gabbla/grippyboi/README.md

# GrippyBoi

Open source and open hardware Haldex gen 1 controller.
