gabbla/grippyboi/JLC04161H-7628_stackup.png

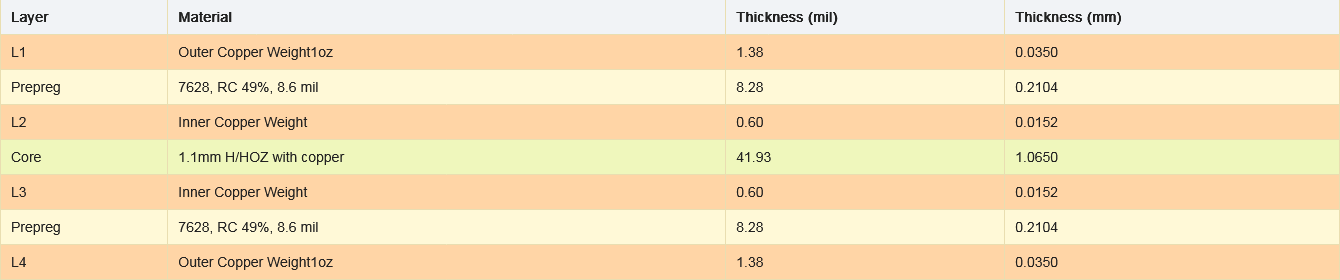
JLC04161H-7628_stackup.png
