gabbla/grippyboi/CHANGELOG.md

# Changelog

## Unreleased

- Fix: Handbrake and Brake light input/output

## [1.0.0] - May 7, 2025

Initial release.
