gabbla/grippyboi/(threads)

Thread 2 (2025-05-22):

F1 is too close to the ECU connector

gabbla, 2025-05-22:

Thread 5 (2025-05-25):

Wrong footprint for L5

gabbla, 2025-05-25:
The footprint for the common mode filter on the usb is wrong.

From the datasheet:
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
