gabbla/grippyboi/grippyboi.kicad_pcb

## KiCad design grippyboi.kicad_pcb (2025-05-07)

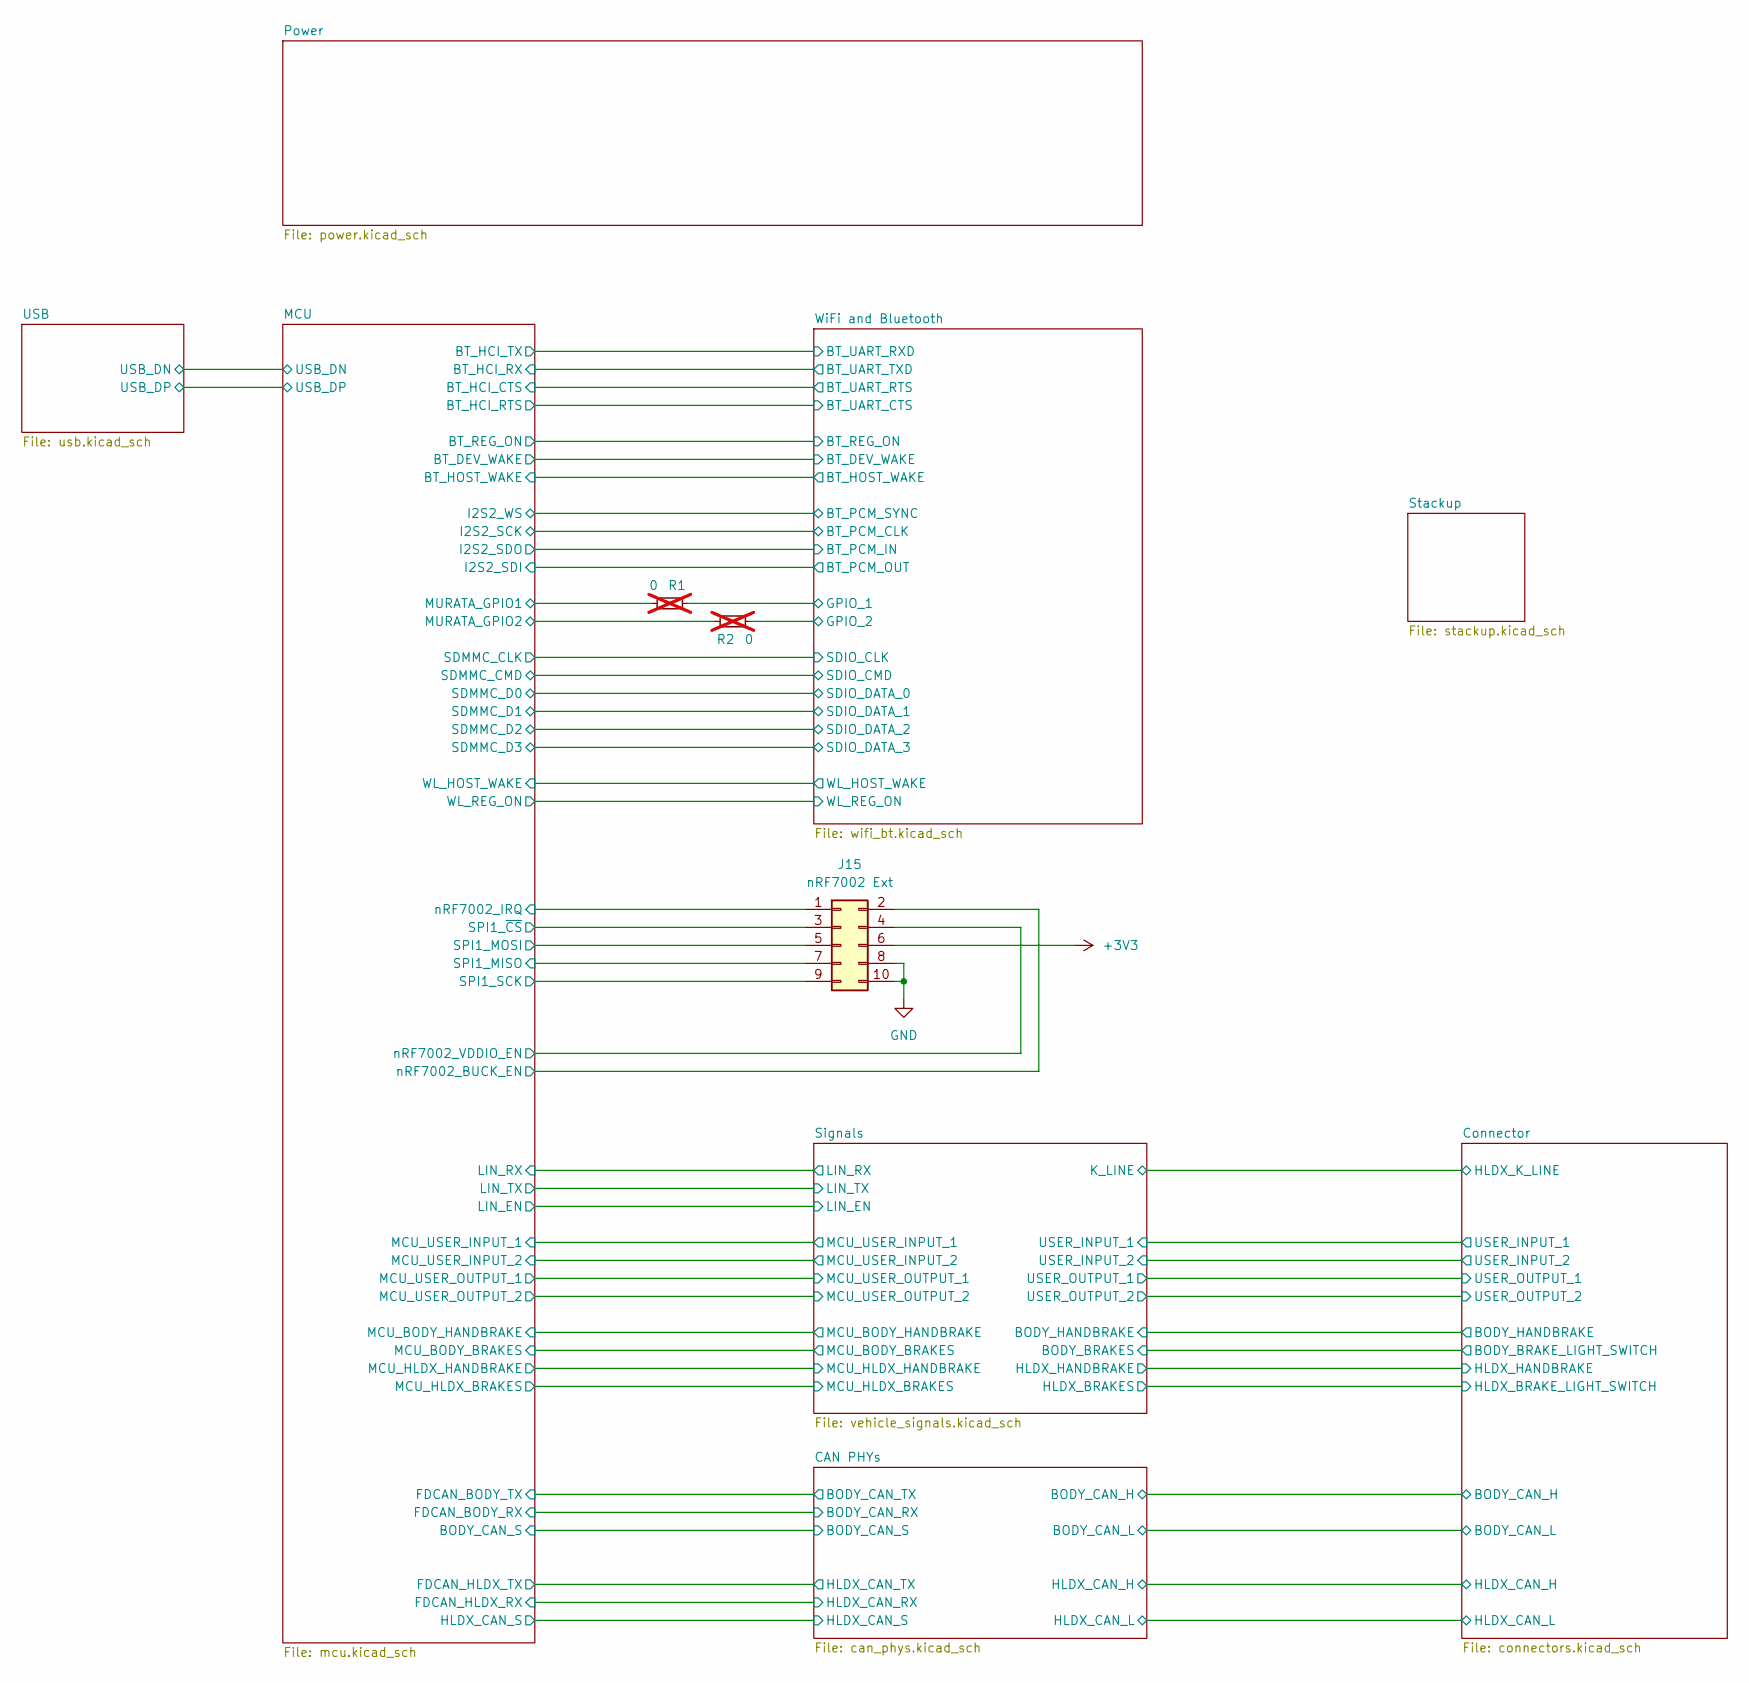
[picture p2: schematic grippyboi.kicad_sch]

Parts:
J15: nRF7002 Ext; PinHeader_2x05_P1.27mm_Vertical
R1, R2: 0; R_0603_1608Metric_Pad0.98x0.95mm_HandSolder; not fitted

Connections:
+3V3: J15.6; also elsewhere on the board
/MCU/MURATA_GPIO1: R1.2; also elsewhere on the board
/MCU/MURATA_GPIO2: R2.1; also elsewhere on the board
/MCU/SPI1_MISO: J15.7; also elsewhere on the board
/MCU/SPI1_MOSI: J15.5; also elsewhere on the board
/MCU/SPI1_SCK: J15.9; also elsewhere on the board
/MCU/SPI1_~CS: J15.3; also elsewhere on the board
/MCU/nRF7002_BUCK_EN: J15.2; also elsewhere on the board
/MCU/nRF7002_IRQ: J15.1; also elsewhere on the board
/MCU/nRF7002_VDDIO_EN: J15.4; also elsewhere on the board
/WiFi and Bluetooth/GPIO_1: R1.1; also elsewhere on the board
/WiFi and Bluetooth/GPIO_2: R2.2; also elsewhere on the board
GND: J15.8, J15.10; also elsewhere on the board

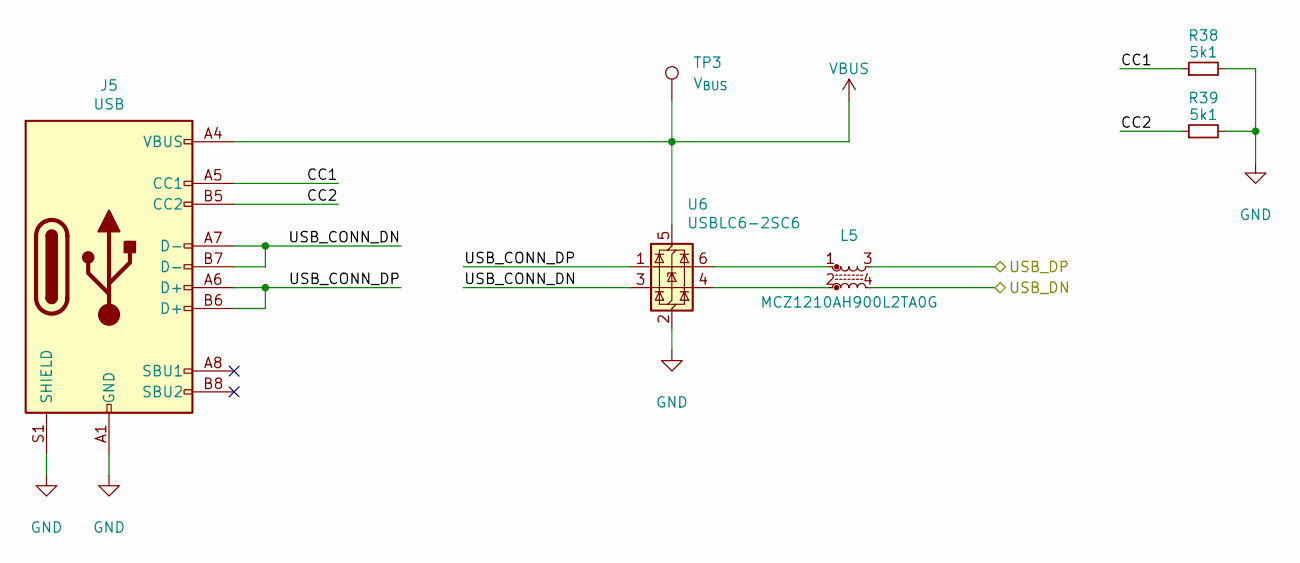
[picture p3: schematic usb.kicad_sch, USB-C]

Parts:
J5: USB; USB_C_Receptacle_G-Switch_GT-USB-7010ASV
L5: MCZ1210AH900L2TA0G; MCZ1210AH201L2TA0G
R38, R39: 5k1; R_0603_1608Metric_Pad0.98x0.95mm_HandSolder
TP3: V_{BUS}; TestPoint_Pad_D1.0mm
U6: USBLC6-2SC6; SOT-23-6

Connections:
/MCU/USB_DN: L5.4; also elsewhere on the board
/MCU/USB_DP: L5.3; also elsewhere on the board
/USB/CC1: J5.A5 (CC1), R38.1
/USB/CC2: J5.B5 (CC2), R39.1
/USB/USB_CONN_DN: J5.A7 (D-), J5.B7 (D-), U6.3 (I/O2)
/USB/USB_CONN_DP: J5.A6 (D+), J5.B6 (D+), U6.1 (I/O1)
GND: J5.A1 (GND), J5.A12 (GND), J5.B1 (GND), J5.B12 (GND), J5.S1 (SHIELD), R38.2, R39.2, U6.2 (GND); also elsewhere on the board
unnamed: L5.1, U6.6 (I/O1)
unnamed: L5.2, U6.4 (I/O2)
VBUS: J5.A4 (VBUS), J5.A9 (VBUS), J5.B4 (VBUS), J5.B9 (VBUS), TP3.1, U6.5 (VBUS)

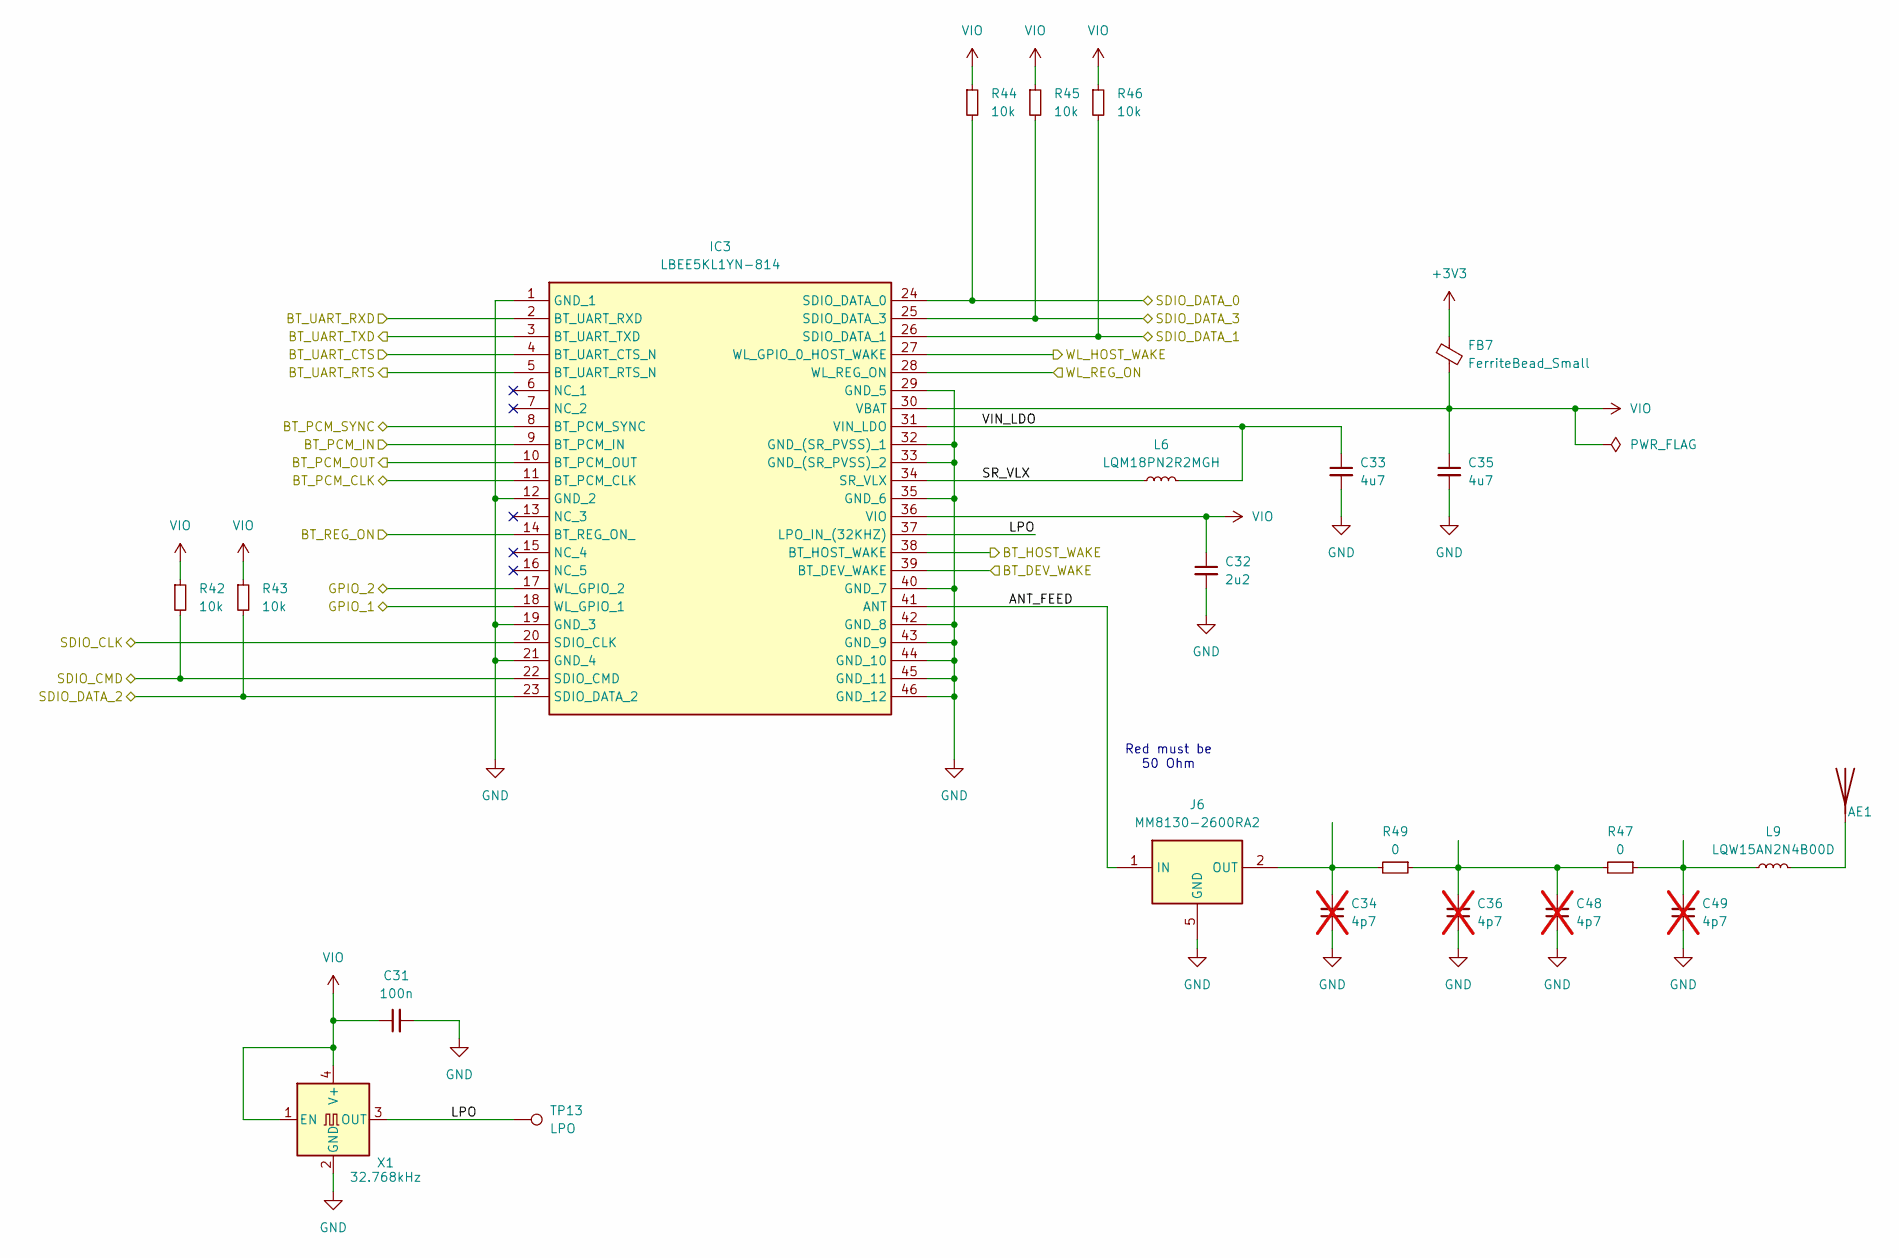
[picture p4: schematic wifi_bt.kicad_sch, WiFi and Bluetooth - Murata 1YN]

Parts:
AE1: type1YN-antenna-p2ml4452-1; 1YN_ANTENNA
C31: 100n; C_0603_1608Metric_Pad1.08x0.95mm_HandSolder
C32: 2u2; C_0603_1608Metric_Pad1.08x0.95mm_HandSolder
C33, C35: 4u7; C_0603_1608Metric_Pad1.08x0.95mm_HandSolder
C34, C36, C48, C49: 4p7; C_0402_1005Metric_Pad0.74x0.62mm_HandSolder; not fitted
FB7: FerriteBead_Small; L_0805_2012Metric_Pad1.05x1.20mm_HandSolder
IC3: LBEE5KL1YN-814; LBEE5KL1YN814; Manufacturer_Part_Number LBEE5KL1YN-814; Mouser Part Number 81-LBEE5KL1YN-814
J6: MM8130-2600RA2; MM81302600RA2; Mouser Part Number 81-MM8130-2600RA2
L6: LQM18PN2R2MGH; L_0603_1608Metric_Pad1.05x0.95mm_HandSolder
L9: LQW15AN2N4B00D; L_0402_1005Metric
R42, R43, R44, R45, R46: 10k; R_0402_1005Metric_Pad0.72x0.64mm_HandSolder
R47, R49: 0; R_0402_1005Metric_Pad0.72x0.64mm_HandSolder
TP13: LPO; TestPoint_Pad_D1.0mm
X1: 32.768kHz; Oscillator_SMD_EuroQuartz_XO32-4Pin_3.2x2.5mm

Connections:
+3V3: FB7.1; also elsewhere on the board
/MCU/BT_DEV_WAKE: IC3.39 (BT_DEV_WAKE); also elsewhere on the board
/MCU/BT_HCI_CTS: IC3.5 (BT_UART_RTS_N); also elsewhere on the board
/MCU/BT_HCI_RTS: IC3.4 (BT_UART_CTS_N); also elsewhere on the board
/MCU/BT_HCI_RX: IC3.3 (BT_UART_TXD); also elsewhere on the board
/MCU/BT_HCI_TX: IC3.2 (BT_UART_RXD); also elsewhere on the board
/MCU/BT_HOST_WAKE: IC3.38 (BT_HOST_WAKE); also elsewhere on the board
/MCU/BT_REG_ON: IC3.14 (BT_REG_ON_); also elsewhere on the board
/MCU/I2S2_SCK: IC3.11 (BT_PCM_CLK); also elsewhere on the board
/MCU/I2S2_SDI: IC3.10 (BT_PCM_OUT); also elsewhere on the board
/MCU/I2S2_SDO: IC3.9 (BT_PCM_IN); also elsewhere on the board
/MCU/I2S2_WS: IC3.8 (BT_PCM_SYNC); also elsewhere on the board
/MCU/SDMMC_CLK: IC3.20 (SDIO_CLK); also elsewhere on the board
/MCU/SDMMC_CMD: IC3.22 (SDIO_CMD), R42.2; also elsewhere on the board
/MCU/SDMMC_D0: IC3.24 (SDIO_DATA_0), R44.2; also elsewhere on the board
/MCU/SDMMC_D1: IC3.26 (SDIO_DATA_1), R46.2; also elsewhere on the board
/MCU/SDMMC_D2: IC3.23 (SDIO_DATA_2), R43.2; also elsewhere on the board
/MCU/SDMMC_D3: IC3.25 (SDIO_DATA_3), R45.2; also elsewhere on the board
/MCU/WL_HOST_WAKE: IC3.27 (WL_GPIO_0_HOST_WAKE); also elsewhere on the board
/MCU/WL_REG_ON: IC3.28 (WL_REG_ON); also elsewhere on the board
/WiFi and Bluetooth/ANT_FEED: IC3.41 (ANT), J6.1 (IN)
/WiFi and Bluetooth/GPIO_1: IC3.18 (WL_GPIO_1); also elsewhere on the board
/WiFi and Bluetooth/GPIO_2: IC3.17 (WL_GPIO_2); also elsewhere on the board
/WiFi and Bluetooth/LPO: IC3.37 (LPO_IN_(32KHZ)), TP13.1, X1.3 (OUT)
/WiFi and Bluetooth/SR_VLX: IC3.34 (SR_VLX), L6.1
/WiFi and Bluetooth/VIN_LDO: C33.1, IC3.31 (VIN_LDO), L6.2
GND: C31.2, C32.2, C33.2, C34.1, C35.2, C36.1, C48.1, C49.1, IC3.1 (GND_1), IC3.12 (GND_2), IC3.19 (GND_3), IC3.21 (GND_4), IC3.29 (GND_5), IC3.32 (GND_(SR_PVSS)_1), IC3.33 (GND_(SR_PVSS)_2), IC3.35 (GND_6), IC3.40 (GND_7), IC3.42 (GND_8), IC3.43 (GND_9), IC3.44 (GND_10), IC3.45 (GND_11), IC3.46 (GND_12), J6.3 (GND), J6.4 (GND), J6.5 (GND), J6.6 (GND), X1.2 (GND); also elsewhere on the board
unnamed: AE1.1 (A), L9.2
unnamed: C36.2, C48.2, R47.2, R49.1
unnamed: C49.2, L9.1, R47.1
unnamed: C34.2, J6.2 (OUT), R49.2
VIO: C31.1, C32.1, C35.1, FB7.2, IC3.30 (VBAT), IC3.36 (VIO), R42.1, R43.1, R44.1, R45.1, R46.1, X1.1 (EN), X1.4 (V+)

Notes on the sheet:
Red must be 50 Ohm

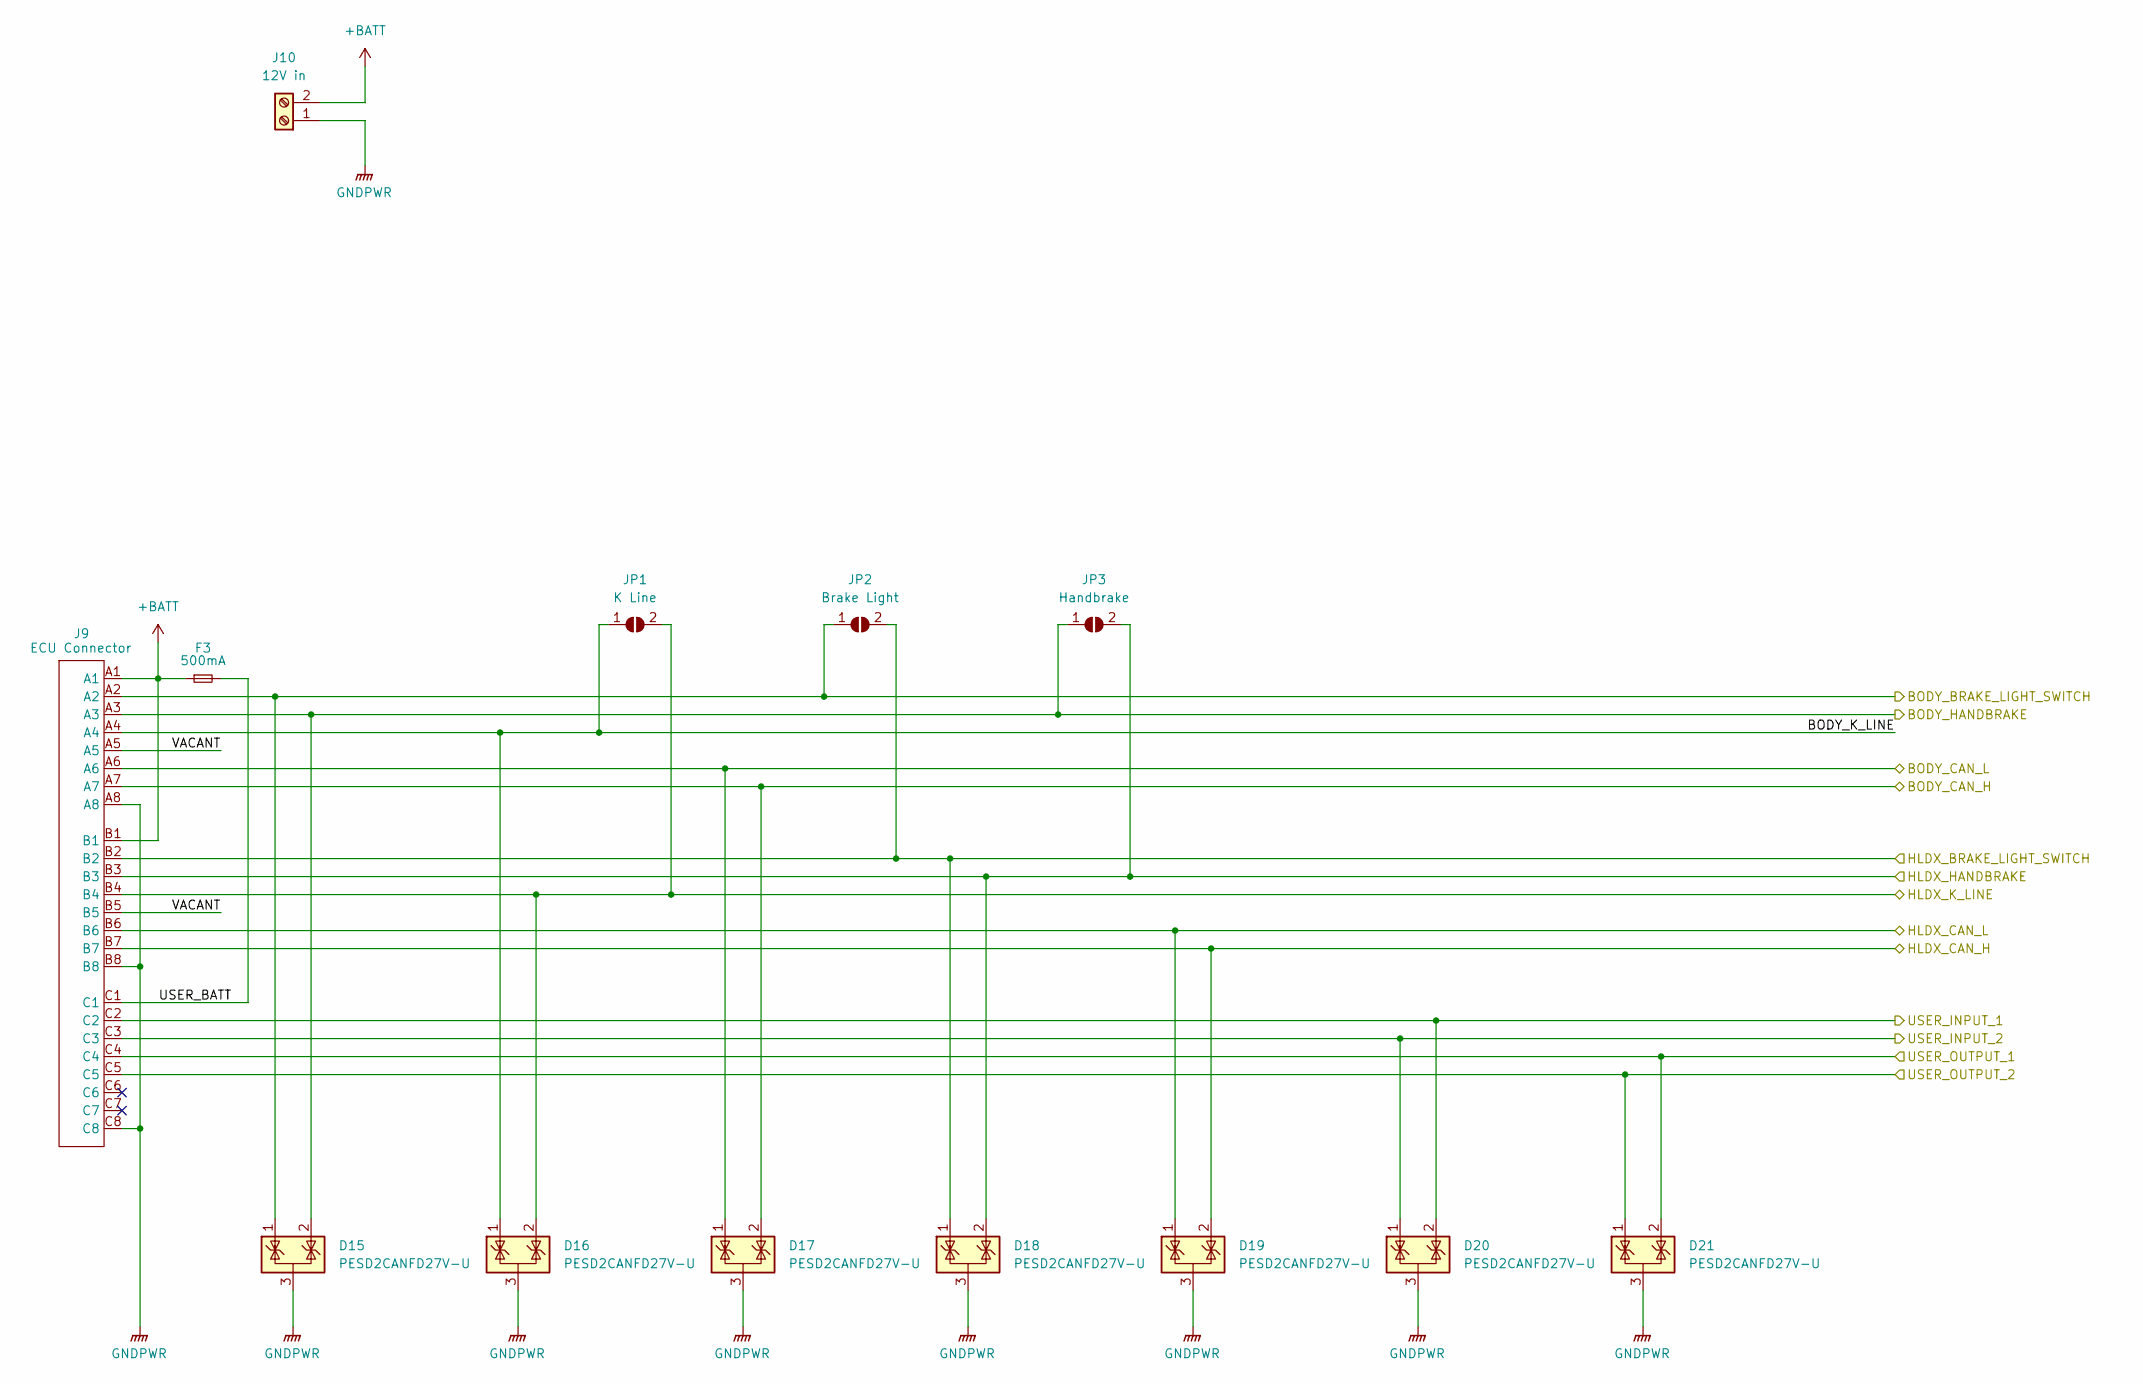
[picture p5: schematic connectors.kicad_sch, Connector]

Parts:
D15, D16, D17, D18, D19, D20, D21: PESD2CANFD27V-U; SOT-23
F3: 500mA; Fuse_1206_3216Metric
J9: ECU Connector; ecu24
J10: 12V in; TerminalBlock_Phoenix_PT-1,5-2-3.5-H_1x02_P3.50mm_Horizontal
JP1: K Line; SolderJumper-2_P1.3mm_Open_TrianglePad1.0x1.5mm
JP2: Brake Light; SolderJumper-2_P1.3mm_Open_TrianglePad1.0x1.5mm
JP3: Handbrake; SolderJumper-2_P1.3mm_Open_TrianglePad1.0x1.5mm

Connections:
+BATT: F3.1, J9.A1, J9.B1, J10.2; also elsewhere on the board
/CAN PHYs/BODY_CAN_H: D17.2 (K), J9.A7; also elsewhere on the board
/CAN PHYs/BODY_CAN_L: D17.1 (K), J9.A6; also elsewhere on the board
/CAN PHYs/HLDX_CAN_H: D19.2 (K), J9.B7; also elsewhere on the board
/CAN PHYs/HLDX_CAN_L: D19.1 (K), J9.B6; also elsewhere on the board
/Connector/BODY_BRAKE_LIGHT_SWITCH: D15.1 (K), J9.A2, JP2.1 (A); also elsewhere on the board
/Connector/BODY_HANDBRAKE: D15.2 (K), J9.A3, JP3.1 (A); also elsewhere on the board
/Connector/BODY_K_LINE: D16.1 (K), J9.A4, JP1.1 (A)
/Connector/HLDX_BRAKE_LIGHT_SWITCH: D18.1 (K), J9.B2, JP2.2 (B); also elsewhere on the board
/Connector/HLDX_HANDBRAKE: D18.2 (K), J9.B3, JP3.2 (B); also elsewhere on the board
/Connector/HLDX_K_LINE: D16.2 (K), J9.B4, JP1.2 (B); also elsewhere on the board
/Connector/USER_BATT: F3.2, J9.C1
/Connector/USER_INPUT_1: D20.2 (K), J9.C2; also elsewhere on the board
/Connector/USER_INPUT_2: D20.1 (K), J9.C3; also elsewhere on the board
/Connector/USER_OUTPUT_1: D21.2 (K), J9.C4; also elsewhere on the board
/Connector/USER_OUTPUT_2: D21.1 (K), J9.C5; also elsewhere on the board
/Connector/VACANT: J9.A5, J9.B5
GNDPWR: D15.3 (A), D16.3 (A), D17.3 (A), D18.3 (A), D19.3 (A), D20.3 (A), D21.3 (A), J9.A8, J9.B8, J9.C8, J10.1; also elsewhere on the board

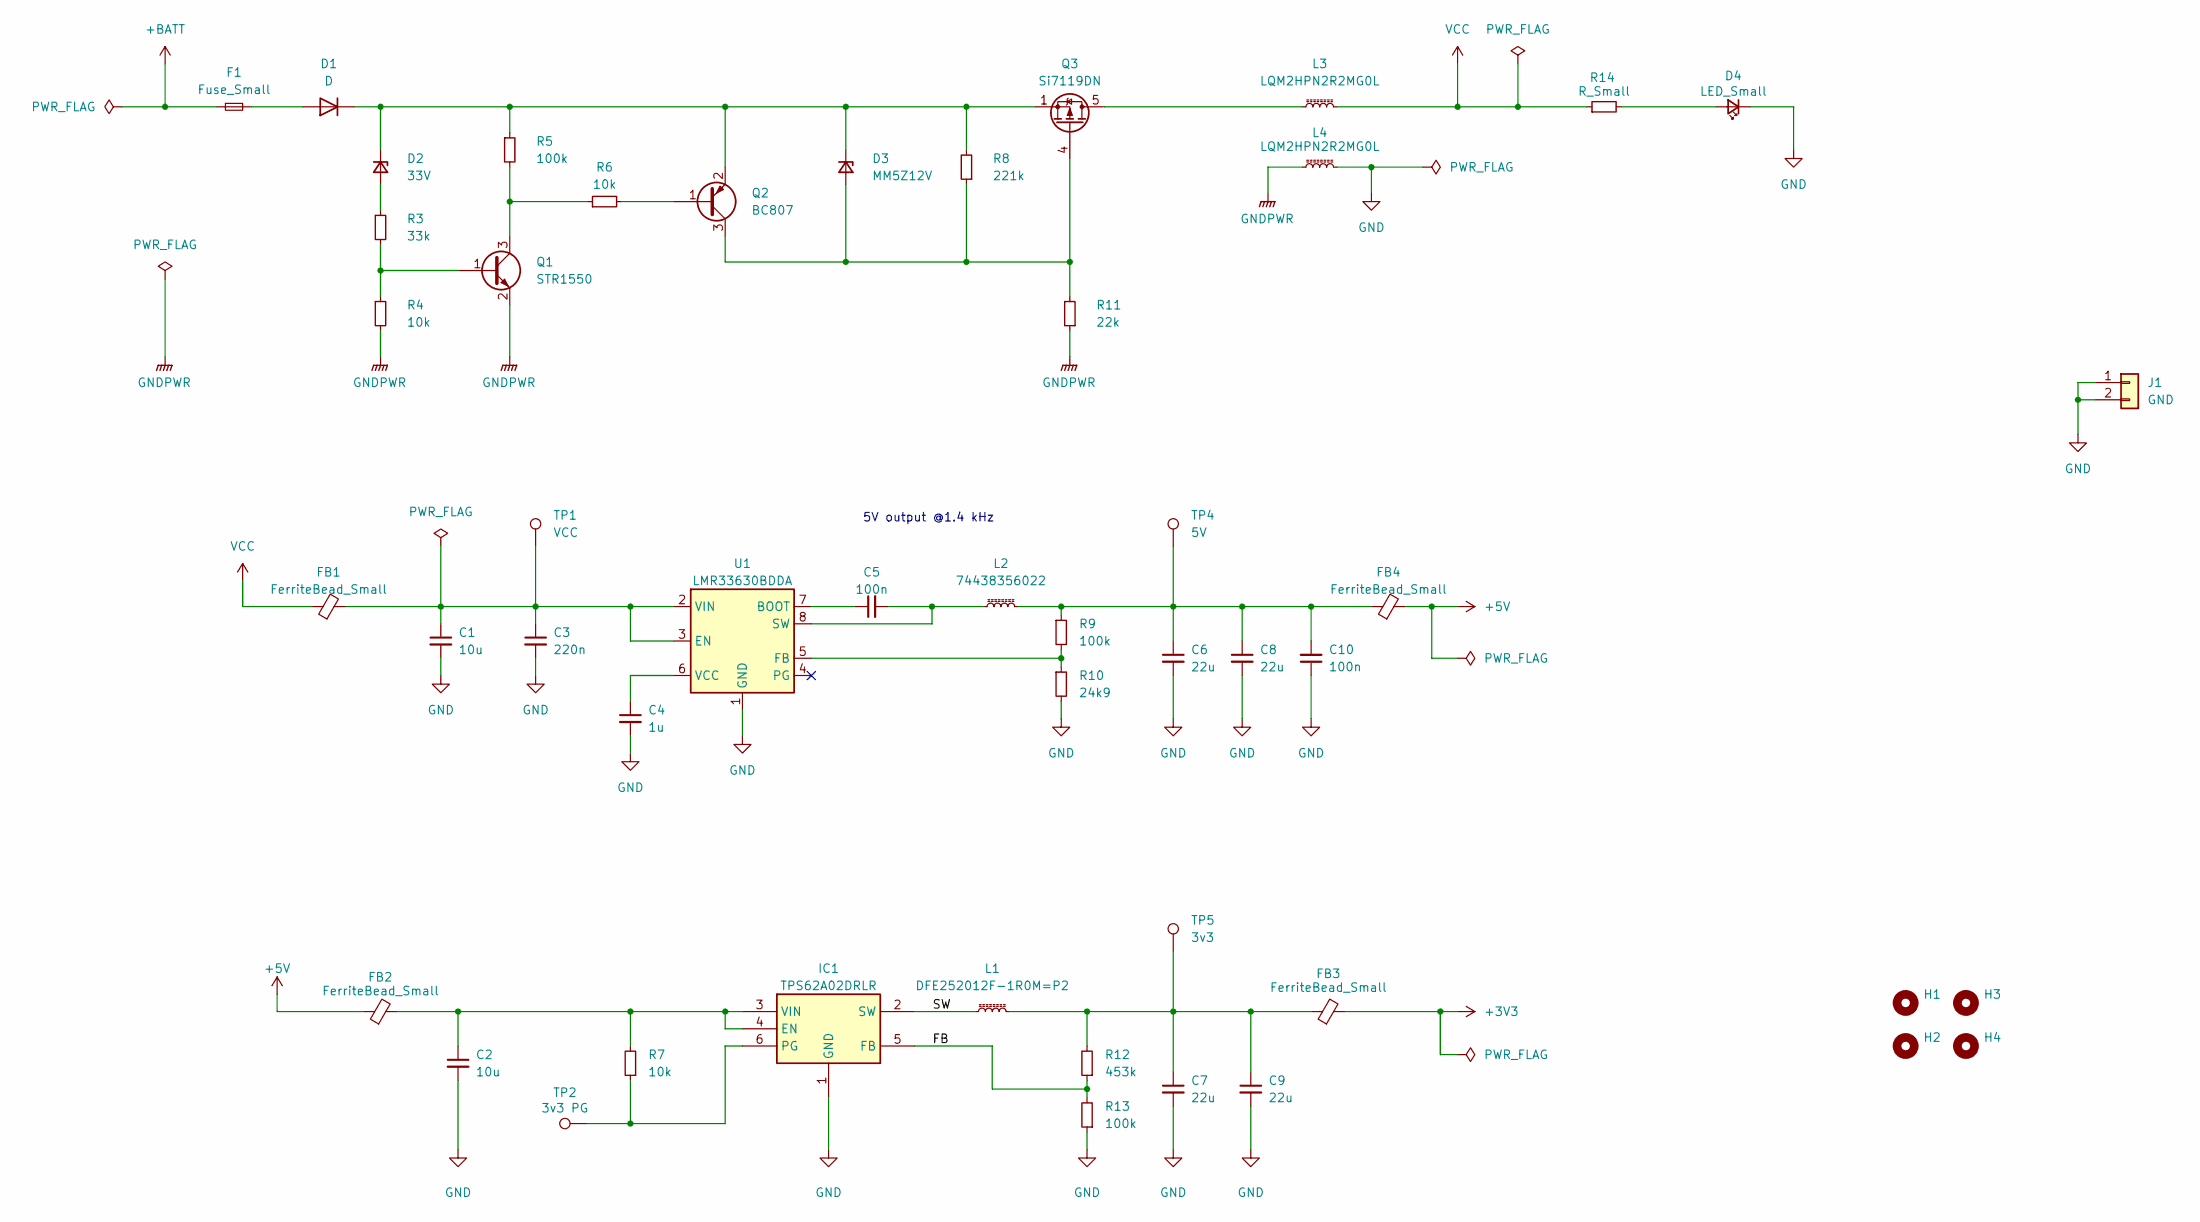
[picture p6: schematic power.kicad_sch]

Parts:
C1, C2: 10u; C_0805_2012Metric_Pad1.18x1.45mm_HandSolder
C3: 220n; C_0603_1608Metric_Pad1.08x0.95mm_HandSolder
C4: 1u; C_0603_1608Metric_Pad1.08x0.95mm_HandSolder
C5, C10: 100n; C_0603_1608Metric_Pad1.08x0.95mm_HandSolder
C6, C7, C8, C9: 22u; C_0805_2012Metric_Pad1.18x1.45mm_HandSolder
D1: D; D_SMB_Handsoldering
D2: 33V; D_SOD-123
D3: MM5Z12V; D_SOD-523
D4: LED_Small; LED_0603_1608Metric_Pad1.05x0.95mm_HandSolder
F1: Fuse_Small; Fuse_1206_3216Metric
FB1, FB2, FB3, FB4: FerriteBead_Small; L_0805_2012Metric_Pad1.05x1.20mm_HandSolder
H1, H2, H3, H4: MountingHole; MountingHole_3.2mm_M3
IC1: TPS62A02DRLR; SOTFL50P160X60-6N; Manufacturer_Part_Number TPS62A02DRLR; Mouser Part Number 595-TPS62A02DRLR
J1: GND; PinHeader_1x02_P2.54mm_Vertical
L1: DFE252012F-1R0M=P2; L_1008_2520Metric_Pad1.43x2.20mm_HandSolder
L2: 74438356022; L_Wuerth_MAPI-4020
L3, L4: LQM2HPN2R2MG0L; L_1008_2520Metric_Pad1.43x2.20mm_HandSolder
Q1: STR1550; TSOT-23
Q2: BC807; SOT-23
Q3: Si7119DN; Vishay_PowerPAK_1212-8_Single
R3: 33k; R_0603_1608Metric_Pad0.98x0.95mm_HandSolder
R4, R6, R7: 10k; R_0603_1608Metric_Pad0.98x0.95mm_HandSolder
R5, R9, R13: 100k; R_0603_1608Metric_Pad0.98x0.95mm_HandSolder
R8: 221k; R_0603_1608Metric_Pad0.98x0.95mm_HandSolder
R10: 24k9; R_0603_1608Metric_Pad0.98x0.95mm_HandSolder
R11: 22k; R_0603_1608Metric_Pad0.98x0.95mm_HandSolder
R12: 453k; R_0603_1608Metric_Pad0.98x0.95mm_HandSolder
R14: R_Small; R_0603_1608Metric_Pad0.98x0.95mm_HandSolder
TP1: VCC; TestPoint_Pad_D1.5mm
TP2: 3v3 PG; TestPoint_Pad_D1.0mm
TP4: 5V; TestPoint_Pad_D1.5mm
TP5: 3v3; TestPoint_Pad_D1.5mm
U1: LMR33630BDDA; Texas_HSOP-8-1EP_3.9x4.9mm_P1.27mm_ThermalVias

Connections:
+3V3: FB3.2; also elsewhere on the board
+5V: FB2.1, FB4.2; also elsewhere on the board
+BATT: F1.1; also elsewhere on the board
/Power/FB: IC1.5 (FB), R12.1, R13.2
/Power/SW: IC1.2 (SW), L1.1
GND: C1.2, C2.2, C3.2, C4.2, C6.2, C7.2, C8.2, C9.2, C10.1, D4.1 (K), IC1.1 (GND), J1.1, J1.2, L4.2, R10.2, R13.1, U1.1 (GND), U1.9 (GND); also elsewhere on the board
GNDPWR: L4.1, Q1.2 (E), R4.2, R11.1; also elsewhere on the board
unnamed: C7.1, C9.1, FB3.1, L1.2, R12.2, TP5.1
unnamed: C6.1, C8.1, C10.2, FB4.1, L2.2, R9.1, TP4.1
unnamed: D1.2 (A), F1.2
unnamed: D1.1 (K), D2.1 (K), D3.1 (K), Q2.2 (E), Q3.1 (S), Q3.2 (S), Q3.3 (S), R5.1, R8.2
unnamed: D2.2 (A), R3.1
unnamed: D3.2 (A), Q2.3 (C), Q3.4 (G), R8.1, R11.2
unnamed: D4.2 (A), R14.2
unnamed: C2.1, FB2.2, IC1.3 (VIN), IC1.4 (EN), R7.2
unnamed: IC1.6 (PG), R7.1, TP2.1
unnamed: Q1.1 (B), R3.2, R4.1
unnamed: Q1.3 (C), R5.2, R6.1
unnamed: Q2.1 (B), R6.2
unnamed: L3.1, Q3.5 (D)
unnamed: C5.1, U1.7 (BOOT)
unnamed: C1.1, C3.1, FB1.2, TP1.1, U1.2 (VIN), U1.3 (EN)
unnamed: R9.2, R10.1, U1.5 (FB)
unnamed: C5.2, L2.1, U1.8 (SW)
unnamed: C4.1, U1.6 (VCC)
VCC: FB1.1, L3.2, R14.1; also elsewhere on the board

Notes on the sheet:
5V output @1.4 kHz

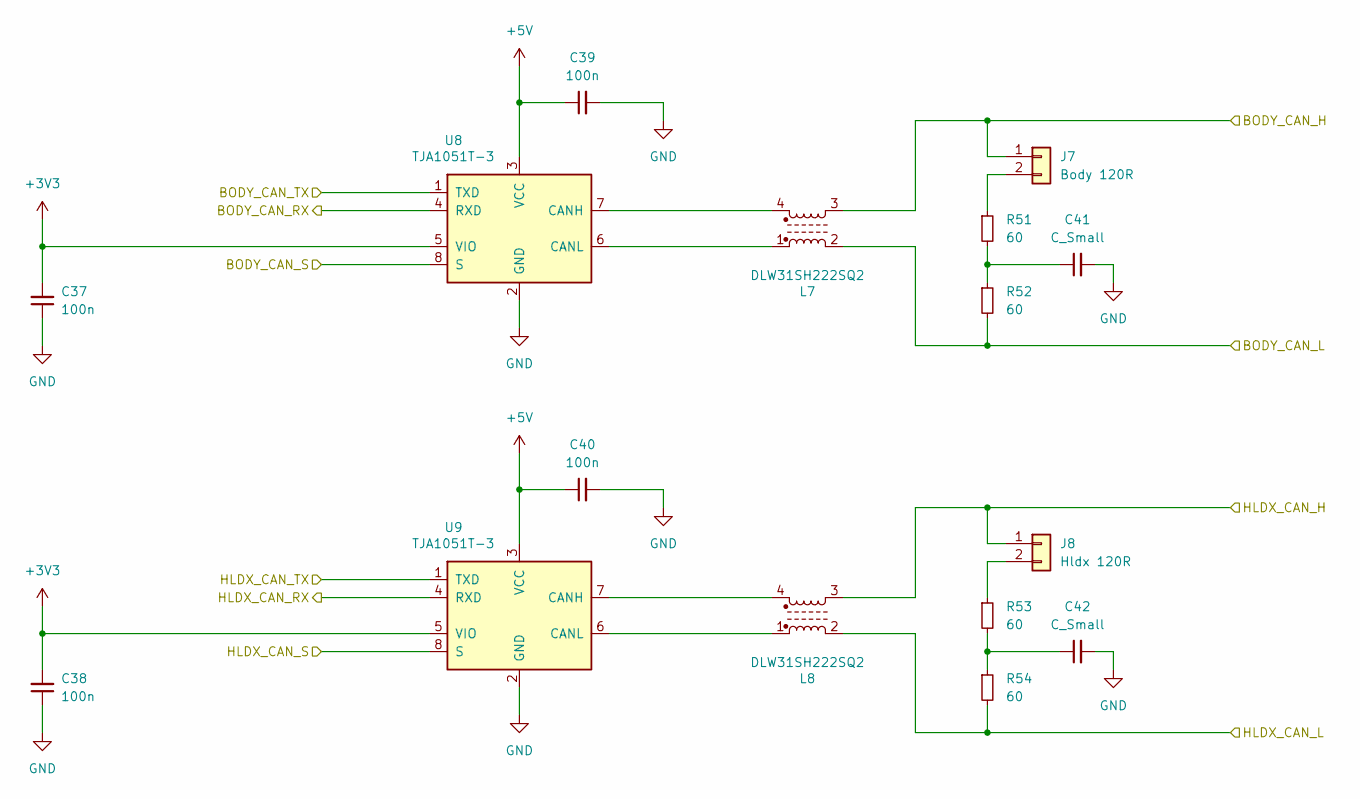
[picture p7: schematic can_phys.kicad_sch, CAN Phys]

Parts:
C37, C38, C39, C40: 100n; C_0603_1608Metric_Pad1.08x0.95mm_HandSolder
C41, C42: C_Small; C_0603_1608Metric_Pad1.08x0.95mm_HandSolder
J7: Body 120R; PinHeader_1x02_P2.54mm_Vertical
J8: Hldx 120R; PinHeader_1x02_P2.54mm_Vertical
L7, L8: DLW31SH222SQ2; DLW31SH222SQ2L
R51, R52, R53, R54: 60; R_0603_1608Metric_Pad0.98x0.95mm_HandSolder
U8, U9: TJA1051T-3; SOIC-8_3.9x4.9mm_P1.27mm

Connections:
+3V3: C37.2, C38.2, U8.5 (VIO), U9.5 (VIO); also elsewhere on the board
+5V: C39.1, C40.1, U8.3 (VCC), U9.3 (VCC); also elsewhere on the board
/CAN PHYs/BODY_CAN_H: J7.1, L7.3; also elsewhere on the board
/CAN PHYs/BODY_CAN_L: L7.2, R52.2; also elsewhere on the board
/CAN PHYs/BODY_CAN_RX: U8.4 (RXD); also elsewhere on the board
/CAN PHYs/BODY_CAN_S: U8.8 (S); also elsewhere on the board
/CAN PHYs/BODY_CAN_TX: U8.1 (TXD); also elsewhere on the board
/CAN PHYs/HLDX_CAN_H: J8.1, L8.3; also elsewhere on the board
/CAN PHYs/HLDX_CAN_L: L8.2, R54.2; also elsewhere on the board
/CAN PHYs/HLDX_CAN_RX: U9.4 (RXD); also elsewhere on the board
/CAN PHYs/HLDX_CAN_S: U9.8 (S); also elsewhere on the board
/CAN PHYs/HLDX_CAN_TX: U9.1 (TXD); also elsewhere on the board
GND: C37.1, C38.1, C39.2, C40.2, C41.2, C42.2, U8.2 (GND), U9.2 (GND); also elsewhere on the board
unnamed: C41.1, R51.2, R52.1
unnamed: C42.1, R53.2, R54.1
unnamed: J7.2, R51.1
unnamed: J8.2, R53.1
unnamed: L7.4, U8.7 (CANH)
unnamed: L7.1, U8.6 (CANL)
unnamed: L8.4, U9.7 (CANH)
unnamed: L8.1, U9.6 (CANL)
