gabbla/grippyboi/grippyboi.kicad_pcb

## KiCad design grippyboi.kicad_pcb (continued)

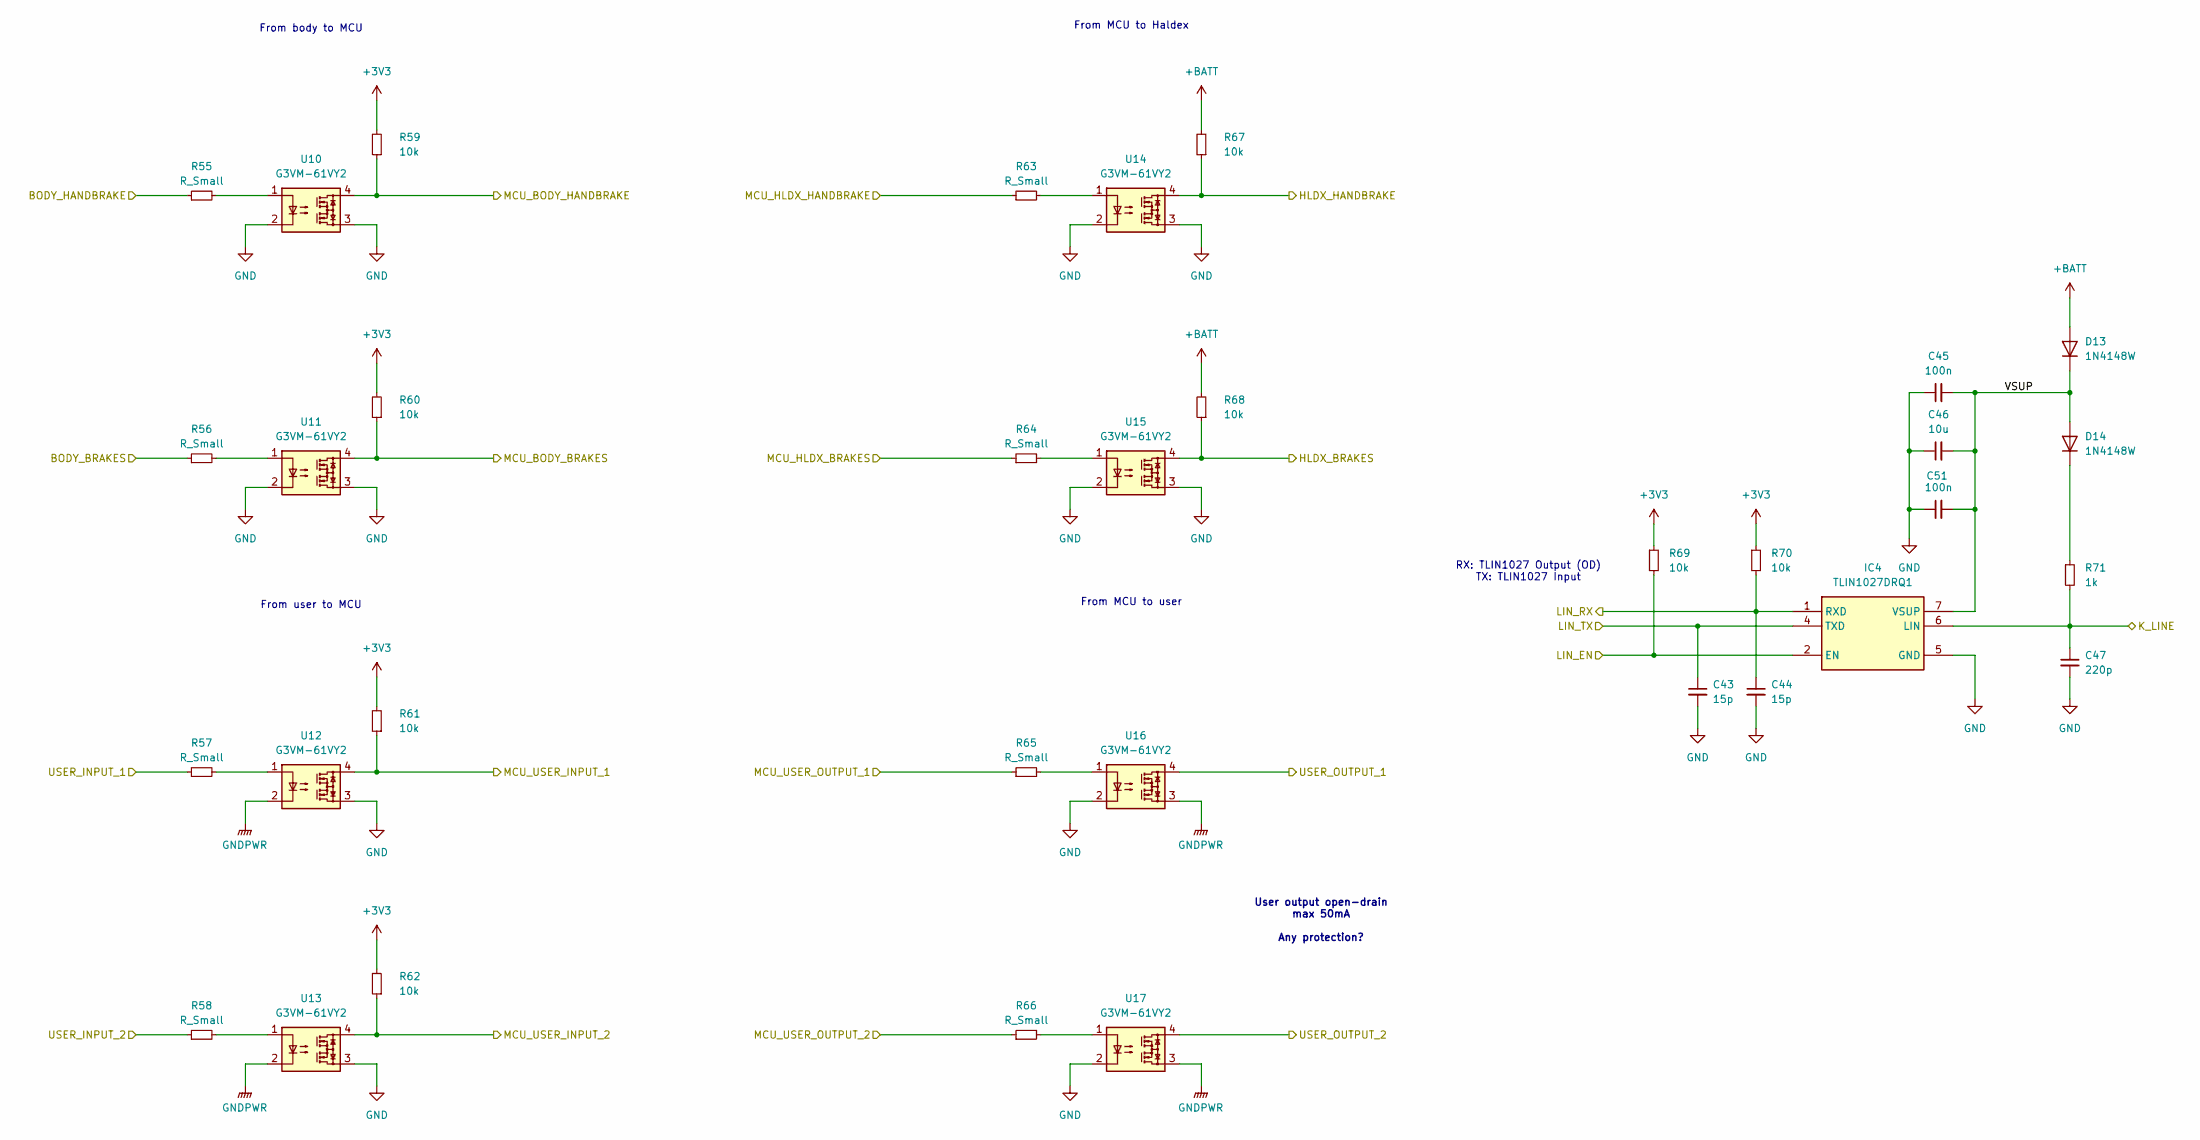
[picture p8: schematic vehicle_signals.kicad_sch, Vehicle Signals]

Parts:
C43, C44: 15p; C_0603_1608Metric_Pad1.08x0.95mm_HandSolder
C45, C51: 100n; C_0603_1608Metric_Pad1.08x0.95mm_HandSolder
C46: 10u; C_0603_1608Metric_Pad1.08x0.95mm_HandSolder
C47: 220p; C_0603_1608Metric_Pad1.08x0.95mm_HandSolder
D13, D14: 1N4148W; D_SOD-123
IC4: TLIN1027DRQ1; SOIC127P600X175-8N; Manufacturer_Part_Number TLIN1027DRQ1; Mouser Part Number 595-TLIN1027DRQ1
R55, R56, R57, R58, R63, R64, R65, R66: R_Small; R_0603_1608Metric_Pad0.98x0.95mm_HandSolder
R59, R60, R61, R62, R67, R68, R69, R70: 10k; R_0603_1608Metric_Pad0.98x0.95mm_HandSolder
R71: 1k; R_1206_3216Metric_Pad1.30x1.75mm_HandSolder
U10, U11, U12, U13, U14, U15, U16, U17: G3VM-61VY2; SOP254P700X230-4N

Connections:
+3V3: R59.2, R60.2, R61.2, R62.2, R69.1, R70.1; also elsewhere on the board
+BATT: D13.2 (A), R67.2, R68.2; also elsewhere on the board
/Connector/BODY_BRAKE_LIGHT_SWITCH: R56.1; also elsewhere on the board
/Connector/BODY_HANDBRAKE: R55.1; also elsewhere on the board
/Connector/HLDX_BRAKE_LIGHT_SWITCH: R68.1, U15.4; also elsewhere on the board
/Connector/HLDX_HANDBRAKE: R67.1, U14.4; also elsewhere on the board
/Connector/HLDX_K_LINE: C47.1, IC4.6 (LIN), R71.2; also elsewhere on the board
/Connector/USER_INPUT_1: R57.1; also elsewhere on the board
/Connector/USER_INPUT_2: R58.1; also elsewhere on the board
/Connector/USER_OUTPUT_1: U16.4; also elsewhere on the board
/Connector/USER_OUTPUT_2: U17.4; also elsewhere on the board
/MCU/LIN_EN: IC4.2 (EN), R69.2; also elsewhere on the board
/MCU/LIN_RX: C44.1, IC4.1 (RXD), R70.2; also elsewhere on the board
/MCU/LIN_TX: C43.1, IC4.4 (TXD); also elsewhere on the board
/MCU/MCU_BODY_BRAKES: R60.1, U11.4; also elsewhere on the board
/MCU/MCU_BODY_HANDBRAKE: R59.1, U10.4; also elsewhere on the board
/MCU/MCU_HLDX_BRAKES: R64.1; also elsewhere on the board
/MCU/MCU_HLDX_HANDBRAKE: R63.1; also elsewhere on the board
/MCU/MCU_USER_INPUT_1: R61.1, U12.4; also elsewhere on the board
/MCU/MCU_USER_INPUT_2: R62.1, U13.4; also elsewhere on the board
/MCU/MCU_USER_OUTPUT_1: R65.1; also elsewhere on the board
/MCU/MCU_USER_OUTPUT_2: R66.1; also elsewhere on the board
/Signals/VSUP: C45.2, C46.2, C51.2, D13.1 (K), D14.2 (A), IC4.7 (VSUP)
GND: C43.2, C44.2, C45.1, C46.1, C47.2, C51.1, IC4.5 (GND), U10.2, U10.3, U11.2, U11.3, U12.3, U13.3, U14.2, U14.3, U15.2, U15.3, U16.2, U17.2; also elsewhere on the board
GNDPWR: U12.2, U13.2, U16.3, U17.3; also elsewhere on the board
unnamed: D14.1 (K), R71.1
unnamed: R55.2, U10.1
unnamed: R56.2, U11.1
unnamed: R57.2, U12.1
unnamed: R58.2, U13.1
unnamed: R63.2, U14.1
unnamed: R64.2, U15.1
unnamed: R65.2, U16.1
unnamed: R66.2, U17.1

Notes on the sheet:
From MCU to Haldex
From user to MCU
From MCU to user
User output open-drain max 50mA Any protection?
From body to MCU
RX: TLIN1027 Output (OD) TX: TLIN1027 Input

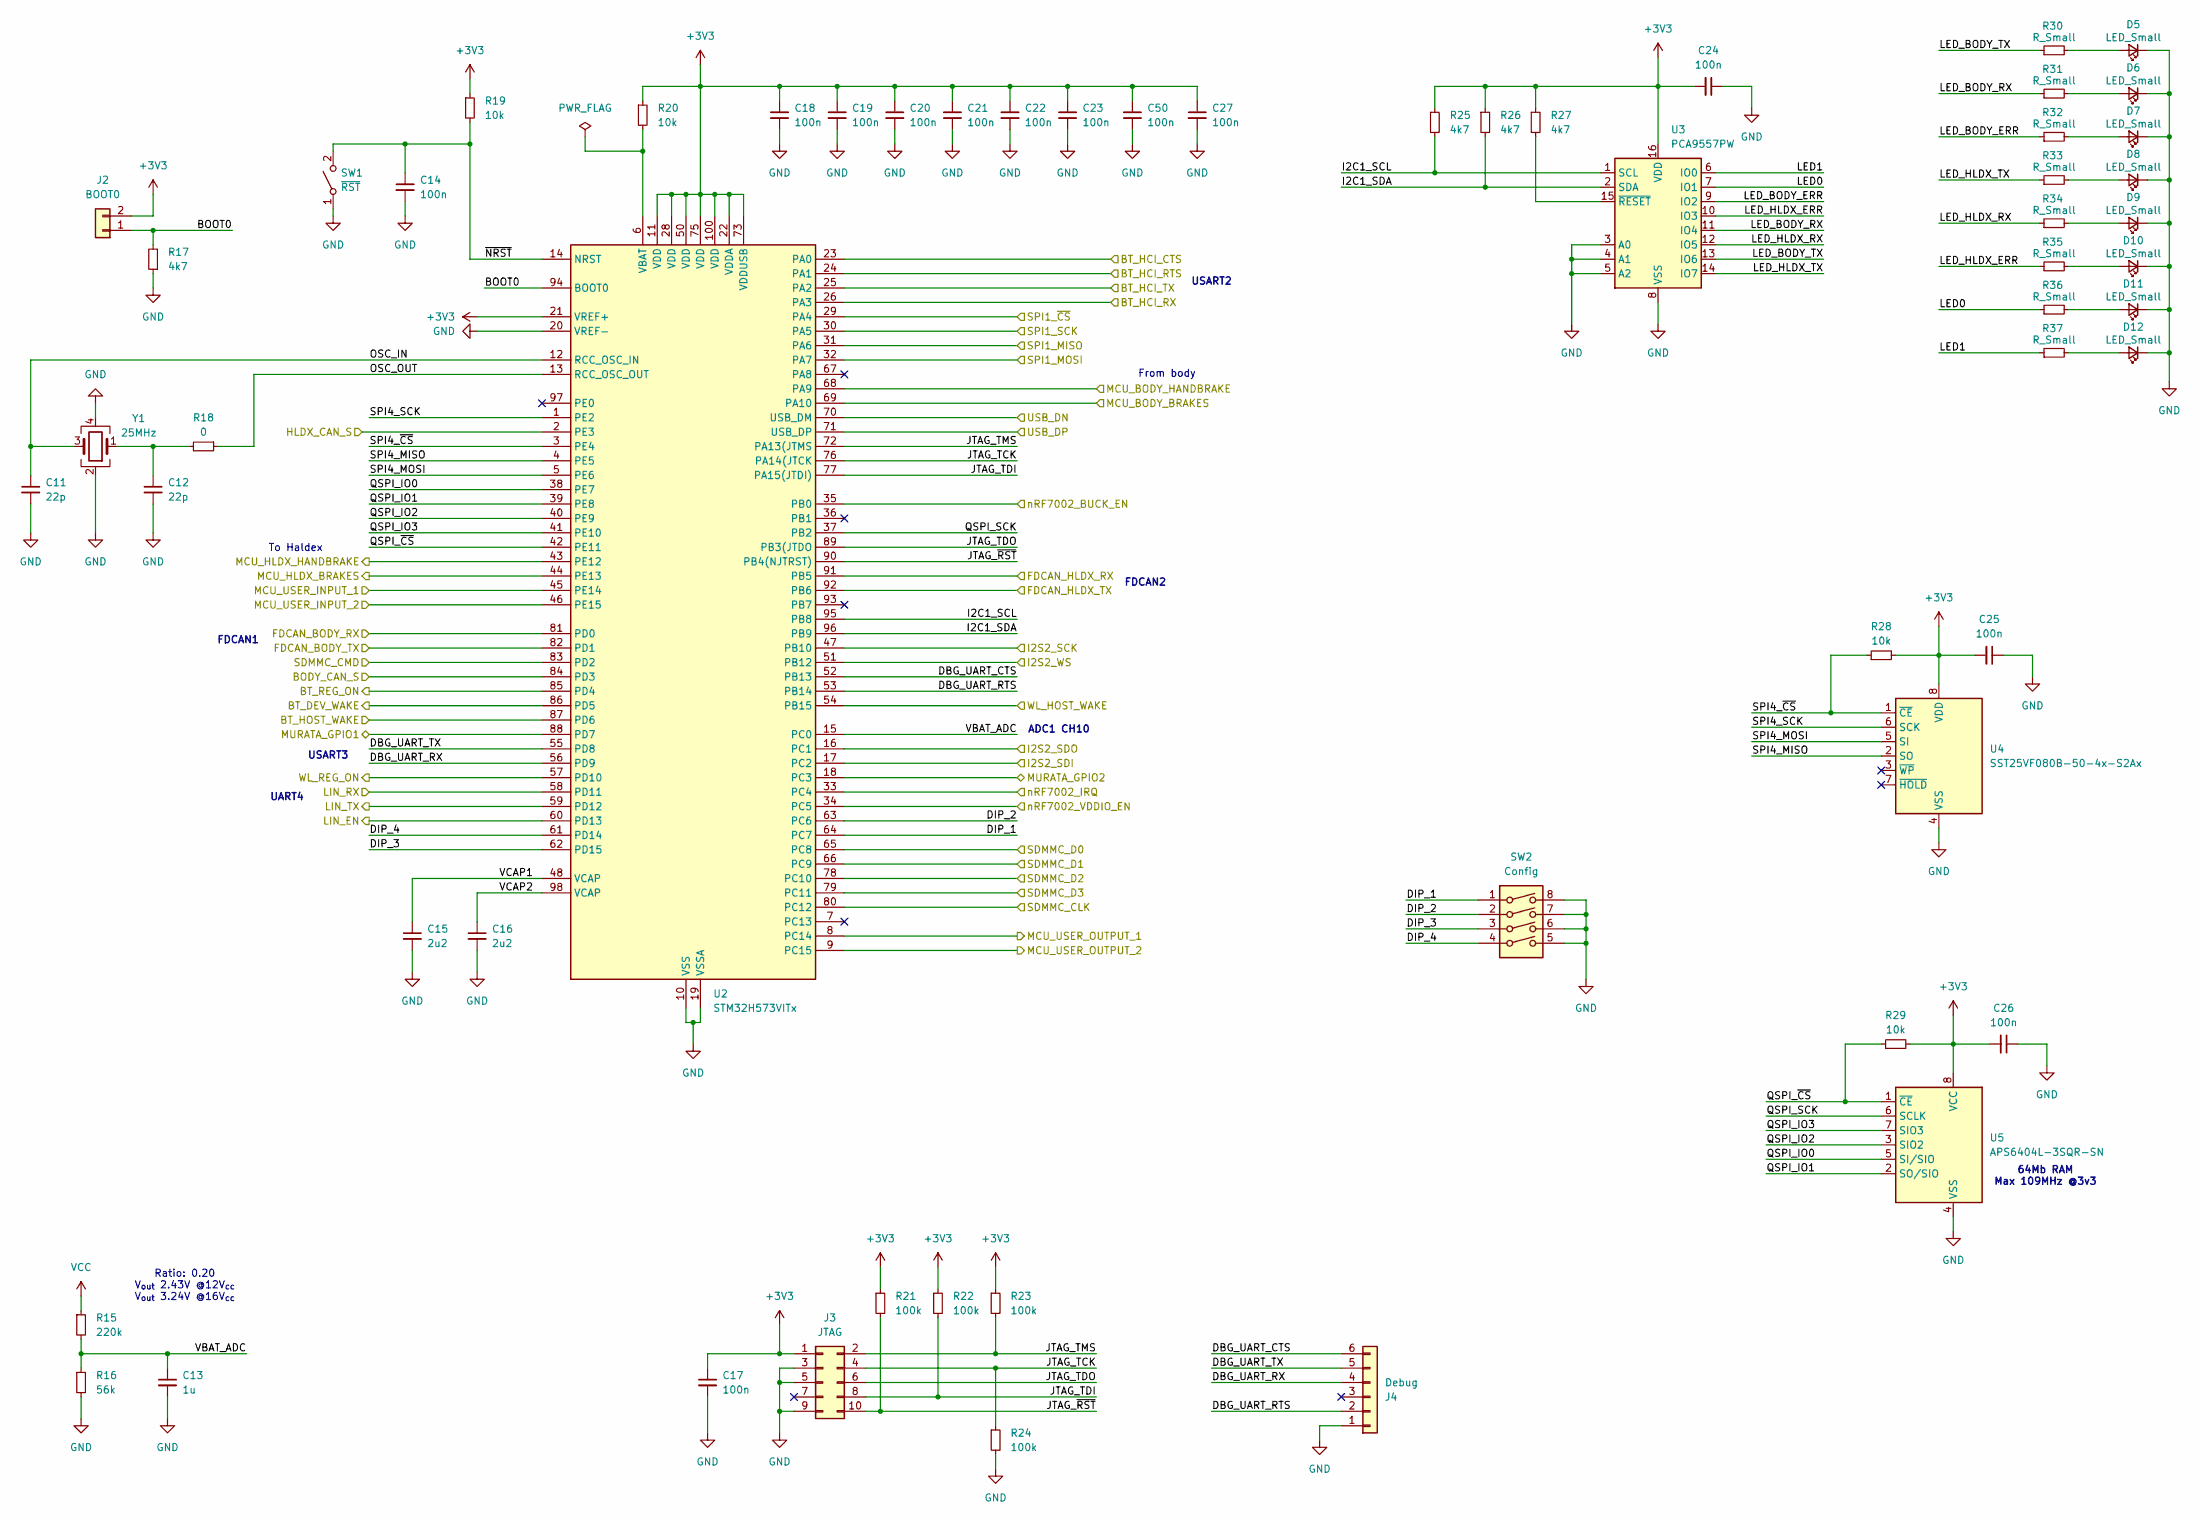
[picture p9: schematic mcu.kicad_sch]

Parts:
C11, C12: 22p; C_0603_1608Metric_Pad1.08x0.95mm_HandSolder
C13: 1u; C_0603_1608Metric_Pad1.08x0.95mm_HandSolder
C14, C17, C18, C19, C20, C21, C22, C23, C24, C25, C26, C27, C50: 100n; C_0603_1608Metric_Pad1.08x0.95mm_HandSolder
C15, C16: 2u2; C_0603_1608Metric_Pad1.08x0.95mm_HandSolder
D5, D6, D7, D8, D9, D10, D11, D12: LED_Small; LED_0603_1608Metric_Pad1.05x0.95mm_HandSolder
J2: BOOT0; PinHeader_1x02_P1.27mm_Vertical
J3: JTAG; PinHeader_2x05_P1.27mm_Vertical
J4: Debug; PinHeader_1x06_P2.54mm_Vertical
R15: 220k; R_0603_1608Metric_Pad0.98x0.95mm_HandSolder
R16: 56k; R_0603_1608Metric_Pad0.98x0.95mm_HandSolder
R17, R25, R26, R27: 4k7; R_0603_1608Metric_Pad0.98x0.95mm_HandSolder
R18: 0; R_0603_1608Metric_Pad0.98x0.95mm_HandSolder
R19, R20, R28, R29: 10k; R_0603_1608Metric_Pad0.98x0.95mm_HandSolder
R21, R22, R23, R24: 100k; R_0603_1608Metric_Pad0.98x0.95mm_HandSolder
R30, R31, R32, R33, R34, R35, R36, R37: R_Small; R_0603_1608Metric_Pad0.98x0.95mm_HandSolder
SW1: ~{RST}; SW_Push_SPST_NO_Alps_SKRK
SW2: Config; SW_DIP_SPSTx04_Slide_Copal_CHS-04A_W5.08mm_P1.27mm_JPin
U2: STM32H573VITx; LQFP-100_14x14mm_P0.5mm
U3: PCA9557PW; TSSOP-16_4.4x5mm_P0.65mm
U4: SST25VF080B-50-4x-S2Ax; SOIC-8_3.9x4.9mm_P1.27mm
U5: APS6404L-3SQR-SN; SOIC-8_3.9x4.9mm_P1.27mm
Y1: 25MHz; Crystal_SMD_3225-4Pin_3.2x2.5mm_HandSoldering

Connections:
+3V3: C17.1, C18.1, C19.1, C20.1, C21.1, C22.1, C23.1, C24.2, C25.2, C26.2, C27.1, C50.1, J2.2, J3.1, R19.1, R20.1, R21.1, R22.1, R23.1, R25.1, R26.1, R27.1, R28.2, R29.2, U2.11 (VDD), U2.21 (VREF+), U2.22 (VDDA), U2.28 (VDD), U2.50 (VDD), U2.73 (VDDUSB), U2.75 (VDD), U2.100 (VDD), U3.16 (VDD), U4.8 (VDD), U5.8 (VCC); also elsewhere on the board
/CAN PHYs/BODY_CAN_RX: U2.81 (PD0); also elsewhere on the board
/CAN PHYs/BODY_CAN_S: U2.84 (PD3); also elsewhere on the board
/CAN PHYs/BODY_CAN_TX: U2.82 (PD1); also elsewhere on the board
/CAN PHYs/HLDX_CAN_RX: U2.91 (PB5); also elsewhere on the board
/CAN PHYs/HLDX_CAN_S: U2.2 (PE3); also elsewhere on the board
/CAN PHYs/HLDX_CAN_TX: U2.92 (PB6); also elsewhere on the board
/MCU/BOOT0: J2.1, R17.2, U2.94 (BOOT0)
/MCU/BT_DEV_WAKE: U2.86 (PD5); also elsewhere on the board
/MCU/BT_HCI_CTS: U2.23 (PA0); also elsewhere on the board
/MCU/BT_HCI_RTS: U2.24 (PA1); also elsewhere on the board
/MCU/BT_HCI_RX: U2.26 (PA3); also elsewhere on the board
/MCU/BT_HCI_TX: U2.25 (PA2); also elsewhere on the board
/MCU/BT_HOST_WAKE: U2.87 (PD6); also elsewhere on the board
/MCU/BT_REG_ON: U2.85 (PD4); also elsewhere on the board
/MCU/DBG_UART_CTS: J4.6, U2.52 (PB13)
/MCU/DBG_UART_RTS: J4.2, U2.53 (PB14)
/MCU/DBG_UART_RX: J4.4, U2.56 (PD9)
/MCU/DBG_UART_TX: J4.5, U2.55 (PD8)
/MCU/DIP_1: SW2.1, U2.64 (PC7)
/MCU/DIP_2: SW2.2, U2.63 (PC6)
/MCU/DIP_3: SW2.3, U2.62 (PD15)
/MCU/DIP_4: SW2.4, U2.61 (PD14)
/MCU/I2C1_SCL: R25.2, U2.95 (PB8), U3.1 (SCL)
/MCU/I2C1_SDA: R26.2, U2.96 (PB9), U3.2 (SDA)
/MCU/I2S2_SCK: U2.47 (PB10); also elsewhere on the board
/MCU/I2S2_SDI: U2.17 (PC2); also elsewhere on the board
/MCU/I2S2_SDO: U2.16 (PC1); also elsewhere on the board
/MCU/I2S2_WS: U2.51 (PB12); also elsewhere on the board
/MCU/JTAG_TCK: J3.4, R24.1, U2.76 (PA14(JTCK)
/MCU/JTAG_TDI: J3.8, R22.2, U2.77 (PA15(JTDI))
/MCU/JTAG_TDO: J3.6, U2.89 (PB3(JTDO)
/MCU/JTAG_TMS: J3.2, R23.2, U2.72 (PA13(JTMS)
/MCU/JTAG_~RST: J3.10, R21.2, U2.90 (PB4(NJTRST))
/MCU/LED0: R36.1, U3.7 (IO1)
/MCU/LED1: R37.1, U3.6 (IO0)
/MCU/LED_BODY_ERR: R32.1, U3.9 (IO2)
/MCU/LED_BODY_RX: R31.1, U3.11 (IO4)
/MCU/LED_BODY_TX: R30.1, U3.13 (IO6)
/MCU/LED_HLDX_ERR: R35.1, U3.10 (IO3)
/MCU/LED_HLDX_RX: R34.1, U3.12 (IO5)
/MCU/LED_HLDX_TX: R33.1, U3.14 (IO7)
/MCU/LIN_EN: U2.60 (PD13); also elsewhere on the board
/MCU/LIN_RX: U2.58 (PD11); also elsewhere on the board
/MCU/LIN_TX: U2.59 (PD12); also elsewhere on the board
/MCU/MCU_BODY_BRAKES: U2.69 (PA10); also elsewhere on the board
/MCU/MCU_BODY_HANDBRAKE: U2.68 (PA9); also elsewhere on the board
/MCU/MCU_HLDX_BRAKES: U2.44 (PE13); also elsewhere on the board
/MCU/MCU_HLDX_HANDBRAKE: U2.43 (PE12); also elsewhere on the board
/MCU/MCU_USER_INPUT_1: U2.45 (PE14); also elsewhere on the board
/MCU/MCU_USER_INPUT_2: U2.46 (PE15); also elsewhere on the board
/MCU/MCU_USER_OUTPUT_1: U2.8 (PC14); also elsewhere on the board
/MCU/MCU_USER_OUTPUT_2: U2.9 (PC15); also elsewhere on the board
/MCU/MURATA_GPIO1: U2.88 (PD7); also elsewhere on the board
/MCU/MURATA_GPIO2: U2.18 (PC3); also elsewhere on the board
/MCU/OSC_IN: C11.1, U2.12 (RCC_OSC_IN), Y1.3
/MCU/OSC_OUT: R18.1, U2.13 (RCC_OSC_OUT)
/MCU/QSPI_IO0: U2.38 (PE7), U5.5 (SI/SIO)
/MCU/QSPI_IO1: U2.39 (PE8), U5.2 (SO/SIO)
/MCU/QSPI_IO2: U2.40 (PE9), U5.3 (SIO2)
/MCU/QSPI_IO3: U2.41 (PE10), U5.7 (SIO3)
/MCU/QSPI_SCK: U2.37 (PB2), U5.6 (SCLK)
/MCU/QSPI_~CS: R29.1, U2.42 (PE11), U5.1 (~CE)
/MCU/SDMMC_CLK: U2.80 (PC12); also elsewhere on the board
/MCU/SDMMC_CMD: U2.83 (PD2); also elsewhere on the board
/MCU/SDMMC_D0: U2.65 (PC8); also elsewhere on the board
/MCU/SDMMC_D1: U2.66 (PC9); also elsewhere on the board
/MCU/SDMMC_D2: U2.78 (PC10); also elsewhere on the board
/MCU/SDMMC_D3: U2.79 (PC11); also elsewhere on the board
/MCU/SPI1_MISO: U2.31 (PA6); also elsewhere on the board
/MCU/SPI1_MOSI: U2.32 (PA7); also elsewhere on the board
/MCU/SPI1_SCK: U2.30 (PA5); also elsewhere on the board
/MCU/SPI1_~CS: U2.29 (PA4); also elsewhere on the board
/MCU/SPI4_MISO: U2.4 (PE5), U4.2 (SO)
/MCU/SPI4_MOSI: U2.5 (PE6), U4.5 (SI)
/MCU/SPI4_SCK: U2.1 (PE2), U4.6 (SCK)
/MCU/SPI4_~CS: R28.1, U2.3 (PE4), U4.1 (~CE)
/MCU/USB_DN: U2.70 (USB_DM); also elsewhere on the board
/MCU/USB_DP: U2.71 (USB_DP); also elsewhere on the board
/MCU/VBAT_ADC: C13.1, R15.2, R16.1, U2.15 (PC0)
/MCU/VCAP1: C15.1, U2.48 (VCAP)
/MCU/VCAP2: C16.1, U2.98 (VCAP)
/MCU/WL_HOST_WAKE: U2.54 (PB15); also elsewhere on the board
/MCU/WL_REG_ON: U2.57 (PD10); also elsewhere on the board
/MCU/nRF7002_BUCK_EN: U2.35 (PB0); also elsewhere on the board
/MCU/nRF7002_IRQ: U2.33 (PC4); also elsewhere on the board
/MCU/nRF7002_VDDIO_EN: U2.34 (PC5); also elsewhere on the board
/MCU/~NRST: C14.1, R19.2, SW1.2 (B), U2.14 (NRST)
GND: C11.2, C12.2, C13.2, C14.2, C15.2, C16.2, C17.2, C18.2, C19.2, C20.2, C21.2, C22.2, C23.2, C24.1, C25.1, C26.1, C27.2, C50.2, D5.1 (K), D6.1 (K), D7.1 (K), D8.1 (K), D9.1 (K), D10.1 (K), D11.1 (K), D12.1 (K), J3.3, J3.5, J3.9, J4.1, R16.2, R17.1, R24.2, SW1.1 (A), SW2.5, SW2.6, SW2.7, SW2.8, U2.10 (VSS), U2.19 (VSSA), U2.20 (VREF-), U2.27 (VSS), U2.49 (VSS), U2.74 (VSS), U2.99 (VSS), U3.3 (A0), U3.4 (A1), U3.5 (A2), U3.8 (VSS), U4.4 (VSS), U5.4 (VSS), Y1.2, Y1.4; also elsewhere on the board
unnamed: C12.1, R18.2, Y1.1
unnamed: D5.2 (A), R30.2
unnamed: D6.2 (A), R31.2
unnamed: D7.2 (A), R32.2
unnamed: D8.2 (A), R33.2
unnamed: D9.2 (A), R34.2
unnamed: D10.2 (A), R35.2
unnamed: D11.2 (A), R36.2
unnamed: D12.2 (A), R37.2
unnamed: R20.2, U2.6 (VBAT)
unnamed: R27.2, U3.15 (~RESET)
VCC: R15.1; also elsewhere on the board

Notes on the sheet:
ADC1 CH10
Ratio: 0.20 V_{out} 2.43V @12V_{cc} V_{out} 3.24V @16V_{cc}
UART4
FDCAN1
From body
FDCAN2
USART3
64Mb RAM Max 109MHz @3v3
To Haldex
USART2

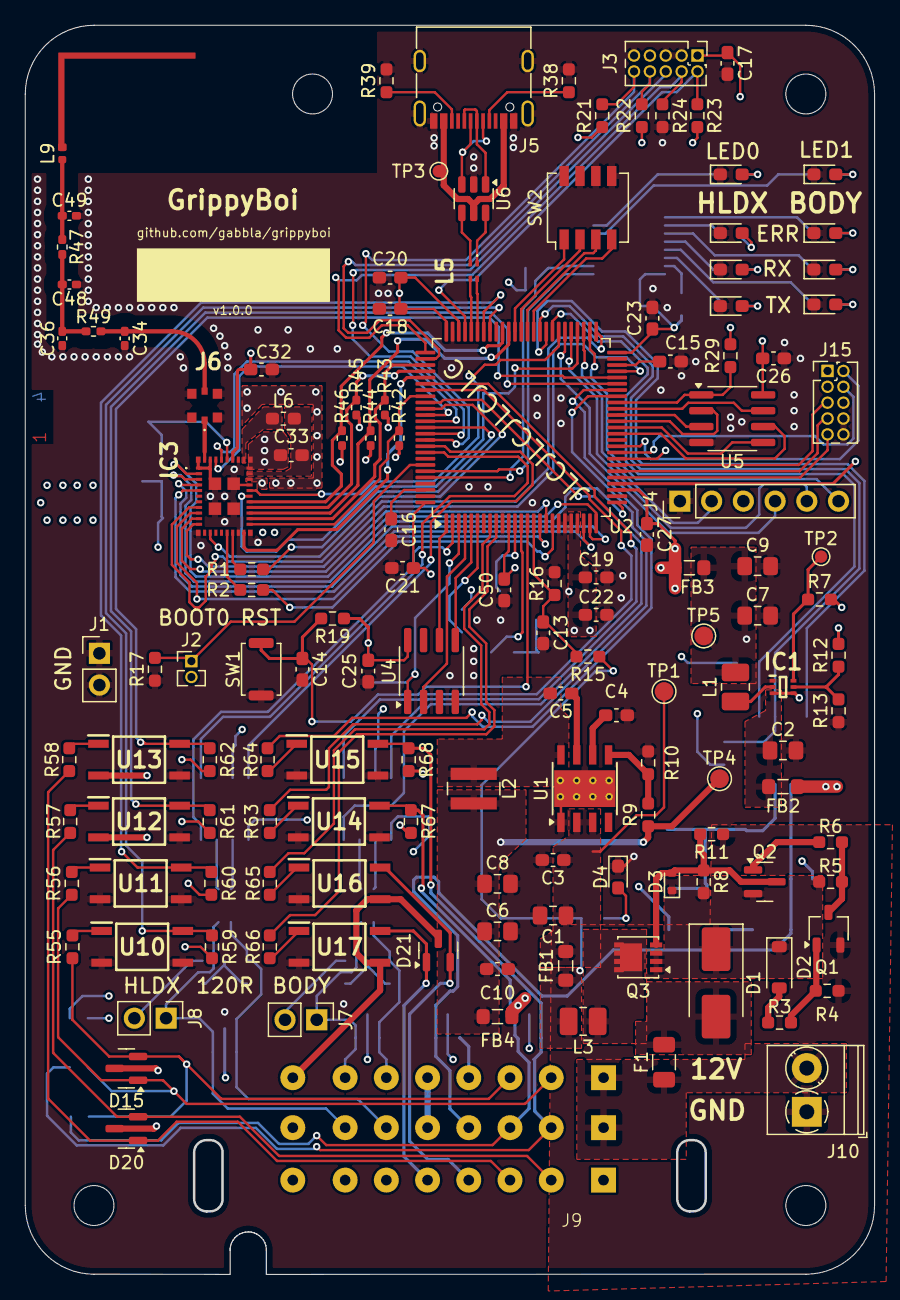
[picture p10: board grippyboi.kicad_pcb from above]

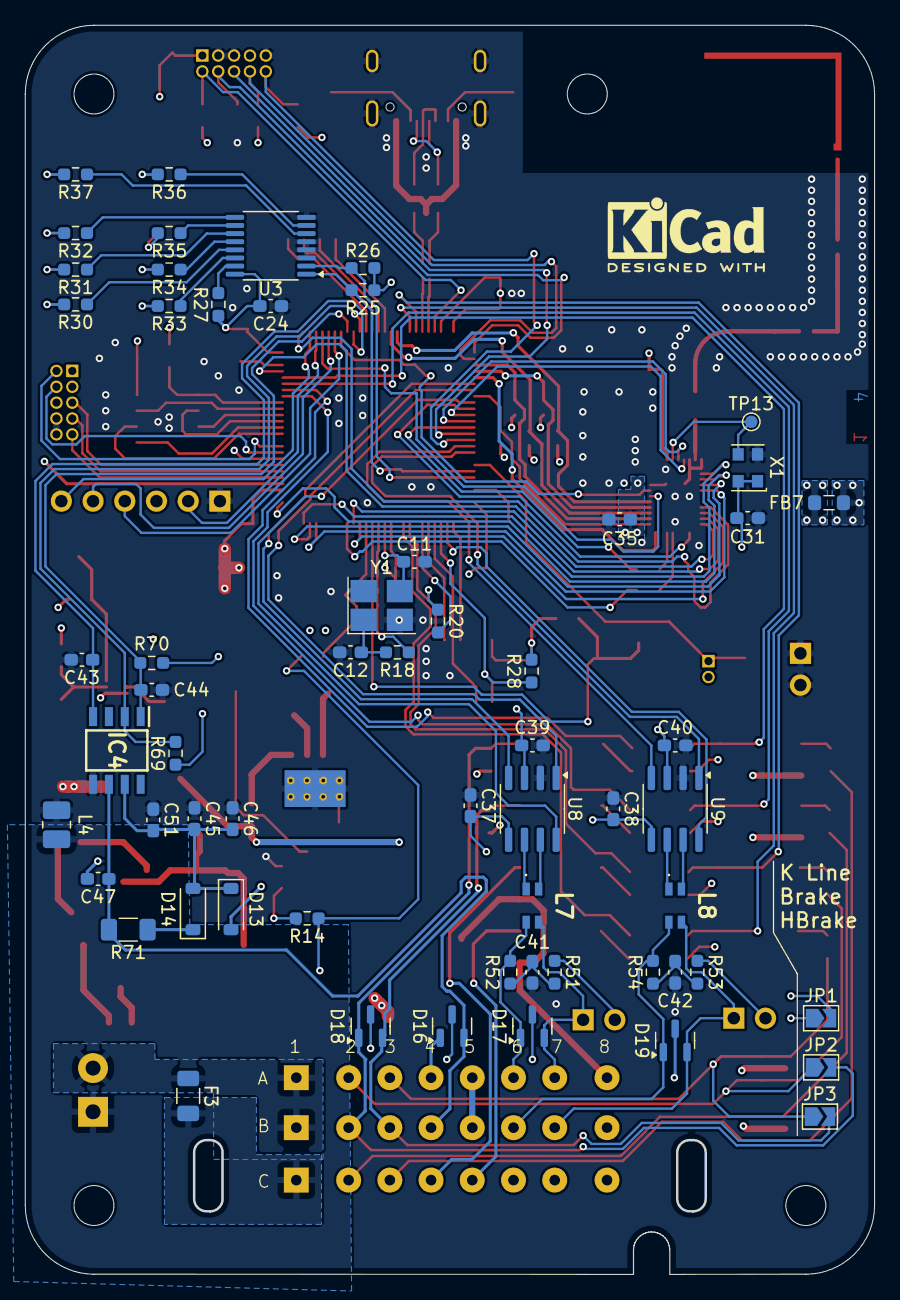
[picture p11: board grippyboi.kicad_pcb from below]

Board: 4 copper layers, 68.0 x 100.0 mm, 203 parts (60 on the bottom side), 176 nets.
