gabbla/grippyboi/grippyboi.ioc

Mcu.UserName=STM32H573VITx
PA0.GPIO_Label=BT_HCI_CTS
PA0.Signal=USART2_CTS
PA1.GPIO_Label=BT_HCI_RTS
PA1.Signal=USART2_RTS
PA10.GPIO_Label=MCU_BRAKES
PA10.Signal=GPIO_Input
PA11.Signal=USB_DM
PA12.Signal=USB_DP
PA13(JTMS/SWDIO).Signal=DEBUG_JTMS-SWDIO
PA14(JTCK/SWCLK).Signal=DEBUG_JTCK-SWCLK
PA15(JTDI).Signal=DEBUG_JTDI
PA2.GPIO_Label=BT_HCI_TX
PA2.Signal=USART2_TX
PA3.GPIO_Label=BT_HCI_RX
PA3.Signal=USART2_RX
PA4.Signal=SPI1_NSS
PA5.Signal=SPI1_SCK
PA6.Signal=SPI1_MISO
PA7.Signal=SPI1_MOSI
PA9.GPIO_Label=MCU_HANDBRAKE
PA9.Signal=GPIO_Input
PB0.GPIO_Label=nrf7002_BUCK_EN
PB0.Signal=GPIO_Input
PB10.Signal=I2S2_CK
PB12.Signal=I2S2_WS
PB13.Signal=USART3_CTS
PB14.Signal=USART3_RTS
PB15.GPIO_Label=WL_HOST_WAKE
PB15.Signal=GPIO_Input
PB2.Signal=OCTOSPI1_CLK
PB3(JTDO/TRACESWO).Signal=DEBUG_JTDO-SWO
PB4(NJTRST).Signal=DEBUG_JTRST
PB5.Signal=FDCAN2_RX
PB6.Signal=FDCAN2_TX
PB7.GPIO_Label=HLDX CAN S
PB7.Signal=GPIO_Output
PB8.Signal=I2C1_SCL
PB9.Signal=I2C1_SDA
PC0.GPIO_Label=VBAT_ADC
PC0.Signal=ADCx_INP10
PC1.Signal=I2S2_SDO
PC10.Signal=SDMMC1_D2
PC11.Signal=SDMMC1_D3
PC12.Signal=SDMMC1_CK
PC14-OSC32_IN(OSC32_IN).GPIO_Label=MCU_USER_OUTPUT_1
PC14-OSC32_IN(OSC32_IN).Signal=GPIO_Output
PC15-OSC32_OUT(OSC32_OUT).GPIO_Label=MCU_USER_OUTPUT_2
PC15-OSC32_OUT(OSC32_OUT).Signal=GPIO_Output
PC2.Signal=I2S2_SDI
PC3.GPIO_Label=MURATA_GPIO2
PC3.Signal=GPIO_Input
PC4.GPIO_Label=nRF7002_IRQ
PC4.Signal=GPIO_Output
PC5.GPIO_Label=nRF7002_VDDIO_EN
PC5.Signal=GPIO_Output
PC6.GPIO_Label=DIP_2
PC6.Signal=GPIO_Input
PC7.GPIO_Label=DIP_1
PC7.Signal=GPIO_Input
PC8.Signal=SDMMC1_D0
PC9.Signal=SDMMC1_D1
PD0.Signal=FDCAN1_RX
PD1.Signal=FDCAN1_TX
PD10.GPIO_Label=WL_REG_ON
PD10.Signal=GPIO_Output
PD11.GPIO_Label=LIN_RX
PD11.Signal=UART4_RX
PD12.GPIO_Label=LIN_TX
PD12.Signal=UART4_TX
PD13.GPIO_Label=LIN_EN
PD13.Signal=GPIO_Output
PD14.GPIO_Label=DIP_4
PD14.Signal=GPIO_Input
PD15.GPIO_Label=DIP_3
PD15.Signal=GPIO_Input
PD2.Signal=SDMMC1_CMD
PD3.GPIO_Label=BODY CAN S
PD3.Signal=GPIO_Output
PD4.GPIO_Label=BT_REG_ON
PD4.Signal=GPIO_Output
PD5.GPIO_Label=BT_DEV_WAKE
PD5.Signal=GPIO_Output
PD6.GPIO_Label=BT_HOST_WAKE
PD6.Signal=GPIO_Input
PD7.GPIO_Label=MURATA_GPIO_1
PD7.Signal=GPIO_Input
PD8.Signal=USART3_TX
PD9.Signal=USART3_RX
PE10.Signal=OCTOSPI1_IO7
PE11.Signal=OCTOSPI1_NCS
PE12.GPIO_Label=SIM_HANDBRAKE
PE12.Signal=GPIO_Output
PE13.GPIO_Label=SIM_BRAKES
PE13.Signal=GPIO_Output
PE14.GPIO_Label=MCU_USER_INPUT_1
PE14.Signal=GPIO_Input
PE15.GPIO_Label=MCU_USER_INPUT_2
PE15.Signal=GPIO_Input
PE2.Signal=SPI4_SCK
PE4.Signal=SPI4_NSS
PE5.Signal=SPI4_MISO
PE6.Signal=SPI4_MOSI
PE7.Signal=OCTOSPI1_IO4
PE8.Signal=OCTOSPI1_IO5
PE9.Signal=OCTOSPI1_IO6
PH0-OSC_IN(PH0).Signal=RCC_OSC_IN
PH1-OSC_OUT(PH1).Signal=RCC_OSC_OUT
