gabbla/grippyboi/(commit log)

2025-03-12 drawings: added title and project name
    [can_phys.kicad_sch, connectors.kicad_sch, haldex_controller.kicad_sch, mcu.kicad_sch, power.kicad_sch, usb.kicad_sch, vehicle_signals.kicad_sch, wifi_bt.kicad_sch]
2025-03-14 lib: ptr7002: footprint added
2025-03-14 sch: added UART4 note on LIN
    [mcu.kicad_sch]
2025-03-14 External RAM changed to APS6404L 64Mbit
    [mcu.kicad_sch]
2025-04-29 io, spi flash, stuff
    [can_phys.kicad_sch, connectors.kicad_sch, haldex_controller.kicad_sch, mcu.kicad_sch, power.kicad_sch, stackup.kicad_sch, usb.kicad_sch, vehicle_signals.kicad_sch]
2025-04-29 page info update
    [can_phys.kicad_sch, connectors.kicad_sch, haldex_controller.kicad_sch, mcu.kicad_sch, power.kicad_sch, stackup.kicad_sch, usb.kicad_sch, vehicle_signals.kicad_sch]
2025-04-29 power: removed FL1
    [power.kicad_sch]
2025-04-29 lib: added G3VM-61VY2 solid state relay
2025-04-29 vehicle signals: using solid state relais
    [vehicle_signals.kicad_sch]
2025-04-29 lib: ptr7002: fix NC pin as passives
2025-04-29 lib: various footprint added
2025-04-29 sch: fixing component footprints
    [can_phys.kicad_sch, connectors.kicad_sch, mcu.kicad_sch, power.kicad_sch, usb.kicad_sch, vehicle_signals.kicad_sch, wifi_bt.kicad_sch, wifi_nrf7002.kicad_sch]
2025-04-30 lib: ecu24: footprint added
2025-04-30 sch: added footprint association
    [connectors.kicad_sch, vehicle_signals.kicad_sch]
2025-04-30 sch: fix association with mounting holes and sw1/sw2
    [mcu.kicad_sch, power.kicad_sch]
2025-04-30 sch: fix footprint association for J6
    [wifi_bt.kicad_sch]
2025-04-30 brd: import from sch
    [haldex_controller.kicad_pcb]
2025-04-30 working on component placement
    [can_phys.kicad_sch, haldex_controller.kicad_pcb, mcu.kicad_sch]
2025-04-30 sch: J10 footprint update
    [connectors.kicad_sch, haldex_controller.kicad_pcb]
2025-05-06 lib: added murata 1yn pcb antenna footprint
2025-05-06 lib: added MM8130 ufl connector
2025-05-06 brd: routing in progress
    [connectors.kicad_sch, haldex_controller.kicad_pcb, mcu.kicad_sch, usb.kicad_sch, vehicle_signals.kicad_sch, wifi_bt.kicad_sch]
2025-05-07 lib: ecu24: fix edge cut
2025-05-07 brd: layout complete
    [connectors.kicad_sch, haldex_controller.kicad_pcb, haldex_controller.kicad_sch, mcu.kicad_sch]
2025-05-07 brd: add version
    [haldex_controller.kicad_pcb]
2025-05-07 sch: update verision on pages
    [can_phys.kicad_sch, connectors.kicad_sch, haldex_controller.kicad_pcb, haldex_controller.kicad_sch, mcu.kicad_sch, power.kicad_sch, stackup.kicad_sch, usb.kicad_sch]
2025-05-07 prj: rename project to grippyboi
    [grippyboi.kicad_pcb, grippyboi.kicad_sch]
2025-05-07 brd: layer order marker added
    [grippyboi.kicad_pcb]
2025-05-22 sch: fix handbrake/brake I/O
    [can_phys.kicad_sch, connectors.kicad_sch, grippyboi.kicad_sch, mcu.kicad_sch, power.kicad_sch, usb.kicad_sch, vehicle_signals.kicad_sch, wifi_bt.kicad_sch]
